kavionic/TeslaDriver/Schematics/TeslaDriverHP/BOM.ods

Id | Designator | Package | Quantity | Designation | Supplier and ref
3 | C1,C6,C7,C8,C9,C10,C11,C13,C15,C17,C19,C21,C23,C25,C29,C30,C31,C32,C34,C35,C36,C37 | C_0603 | 22 | 100n
2 | C2,C3,C4,C5,C12,C14,C16,C18,C20,C22,C24,C26 | C_0603 | 12 | 1u
5 | R1,R2 | R_0603 | 2 | 4k7
11 | R3,R4,R5,R6 | R_1206 | 4 | 2
1 | D5,D6,D7,D8,D13,D14,D15,D16 | Diode-SMA_Standard | 8 | SS210
9 | D1,D2,D3,D4,D9,D10,D11,D12 | MELF_Standard | 8 | ZMY12
12 | U3,U4,U5,U6 | SOIC-8_3.9x4.9mm_Pitch1.27mm | 4 | NCP81071A
13 | U1,U2 | TO-92_Inline_Narrow_Oval | 2 | DS18B20
7 | P1 | PinHeaderMale_2x08 | 1 | CONTROL
19 | C27,C28 | C_Radial_D16_L25_P7.5 | 2 | 1000u/63V
4 | C33,C38 | C_Rect_L18_W8_P15 | 2 | 2.2u/63V
6 | Q2,Q1,Q3,Q4 | TO-220 | 4 | STP65NF06
14 | P2 | PowerPad15_5 | 1 | PWR_IN+
15 | P3 | PowerPad15_5 | 1 | PWR_GND
16 | P4 | PowerPad15_5 | 1 | PWR_OUT_L1
17 | P5 | PowerPad15_5 | 1 | PWR_OUT_L2
18 | T4,T3,T2,T1 | GateTR10x4 | 4 | GateTR10x4
10 | M1,M2,M3,M4 | MH7x3 | 4 | MountingHole
