kavionic/TeslaDriver/Schematics/TeslaDriverHP/DualGateDriver.ods

Id | Designator | Package | Quantity | Designation | Supplier and ref
3 | C1,C7 | C_0603 | 2 | NP |  | 0
4 | C2,C3,C4 | C_0603 | 3 | 1u |  | 3
5 | C5,C6,C8,C10,C11,C12 | C_0603 | 6 | 100n |  | 6
6 | C9,C13 | C_1206 | 2 | 10u |  | 2
7 | D1,D3 | MELF_Standard | 2 | ZMY12 |  | 0
8 | D2,D5 | Diode-SMA_Standard | 2 | SS210 |  | 0
9 | D4,D6 | SMini2-F5-B | 2 | DZ2J130M0L |  | 2
10 | R1,R2,R9,R10 | R_1206 | 4 | 1 |  | 0
11 | R3,R4,R6,R8 | R_1206 | 4 | 3R9 (1) |  | 2
12 | R5,R7 | R_0603 | 2 | NP
13 | U2 | SOIC-8_3.9x4.9mm_Pitch1.27mm | 1 | L78L05ACD |  | 1
14 | U3 | SOIC-16_7.5x10.3mm_Pitch1.27mm | 1 | SI8233 |  | 1
15 | U5,U6 | NXE2_DCDC | 2 | NXE2S1212MC |  | 2
1 | U1,U4 | GateDriverSub | 2 | GateDriver
