kavionic/TeslaDriver/Schematics/TeslaDriverHP/GateDriver.ods

Id | Designator | Package | Quantity | Designation | Supplier and ref
1 | U1 | SOIC-8_3.9x4.9mm_Pitch1.27mm | 1 | NCP81071A
2 | C2,C3,C7,C8,C11 | C_0603 | 5 | 100n
3 | C4,C5,C9,C10 | C_0603 | 4 | 1u
5 | D1,D2 | Diode-SMA_Standard | 2 | SS210
6 | D3,D4 | MELF_Standard | 2 | ZMY12
7 | R1,R3 | R_1206 | 2 | 4R3
8 | R2,R4 | R_1206 | 2 | 1
9 | T1 | GateTR10x4_HV | 1 | GateTR10x4
10 | U2 | GateDriverSub | 1 | GateDriver
12 | C1,C6 | C_0603 | 2 | NP
11 | M1 | MH6 | 1 | MountingHole
