kavionic/TeslaDriver/Schematics/TeslaDriverHP2/TeslaDriver.ods

Id | Designator | Package | Quantity | Designation | Supplier and ref
2 | Q1,Q2,Q3,Q4 | TO-247 | 4 | IRFP4310ZPbF | Digi-Key: IRFP4310ZPBF-ND
7 | U5,U6 | TO-92_Inline_Narrow_Oval | 2 | DS18B20 | Ebay (Digi-Key: DS18B20+-ND)
9 | D1,D2,D3,D4 | DO-214AB | 4 | SK520 | Digi-Key: 1655-1603-1-ND
5 | C29,C30 | C_0603 | 2 | 100n | Digi-Key: 1276-1936-2-ND
8 | C5,C6,C7,C8,C9,C10,C11,C12,C13,C14,C15,C16,C17,C18,C19,C20,C21,C22,C23,C24,C25,C26,C27,C28 | C_0805 | 24 | 3n9/250V | Digi-Key: 445-15288-1-ND
3 | C1,C2 | C_Radial_D16_L25_P7.5 | 2 | 1000u/63V | Digi-Key: 399-6624-ND
12 | C3,C4 | C_Rect_L18_W8_P15 | 2 | 2.2u/63V | Ebay (Digi-Key: 495-4176-ND)
4 | R1,R14,R15 | R_0603 | 3 | 4k7 | Digi-Key: 311-4.70KHRTR-ND
10 | R2,R3,R4,R5,R6,R7,R8,R9,R10,R11,R12,R13 | R_2512 | 12 | 1 | Digi-Key: CRM2512-JW-1R0ELFCT-ND
11 | P3 | PinHeaderMale_2x08 | 1 | CONTROL
1 | U4,U1,U2,U3 | GateDriverMain | 4 | GateDriver
13 | P1 | PowerPad15_5_via | 1 | PWR_IN+
14 | P2 | PowerPad15_5_via | 1 | PWR_GND
15 | P4 | PowerPad15_5_via | 1 | PWR_OUT_L1
16 | P5 | PowerPad15_5_via | 1 | PWR_OUT_L2
6 | M1,M2,M3,M4 | MH7x3 | 4 | MountingHole
