kavionic/TeslaDriver/Schematics/TeslaController/TeslaController.ods

Id | Designator | Package | Quantity | Designation | Supplier and ref
7 | R10,R29 | R_0603 | 2 | 150
11 | R31 | R_0603 | 1 | 300
2 | R4 | R_0603 | 1 | 620
5 | R7,R9,R12,R32 | R_0603 | 4 | 1k
10 | R30 | R_0603 | 1 | 1k2
3 | R5 | R_0603 | 1 | 3k6
9 | R13,R14,R15,R16,R17,R18,R19,R20,R21,R22,R23,R24,R25,R26,R27,R28,R33,R34 | R_0603 | 18 | 4k7
4 | R6 | R_0603 | 1 | 6k8
1 | R1,R2,R3 | R_0603 | 3 | 10k
6 | R8 | R_0603 | 1 | 20k
8 | R11 | R_0603 | 1 | 68k
14 | C9,C13 | C_0603 | 2 | 10p
13 | C4,C10,C15,C21 | C_0603 | 4 | 1n
12 | C2,C3,C6,C7,C8,C11,C14,C17,C18,C19,C22,C20 | C_0603 | 12 | 100n
36 | L1 | L_1206 | 1 | 10u
15 | Y1 | Crystal-3225 | 1 | DSX321SH
16 | U4 | SOT-23 | 1 | TL431DBZ
17 | U3 | SOT-223 | 1 | AP1117D33
18 | U2 | SOT-223 | 1 | AP1117D50
19 | U1 | SOT-223 | 1 | AP1117
20 | Q9,Q8,Q7,Q6,Q5,Q4,Q3,Q2,Q1 | SOT-23 | 9 | BSS138
38 | D3,D2 | SOT-23 | 2 | BAT54S
39 | D1 | SOD-323 | 1 | BZX384-C3V6
40 | C16,C12 | c_elec_5x5.7 | 2 | 100u/10V
41 | C5,C1 | c_elec_6.3x7.7 | 2 | 100u/25V
27 | P10 | MicroSD | 1 | MicroSD
37 | IC1 | TQFP-64_14x14mm_Pitch0.8mm | 1 | ATXMEGA256A3-A
31 | P6 | PiezoBuzzer_17mm_SMD | 1 | BUZZER
42 | RV1 | Potentiometer_Tri5x5 | 1 | 10k
21 | P17 | PinHeaderMale_2x03 | 1 | CURRENT_SENS
22 | P16 | PinHeader_1x03 | 1 | TEMP2
23 | P15 | PinHeader_1x03 | 1 | TEMP1
24 | P14 | PinHeader_1x03 | 1 | INV_EN
25 | P13 | PinHeaderMale_2x06 | 1 | DISPLAY
26 | P11 | PinHeaderMale_2x04 | 1 | KEYBOARD
28 | P9 | PinHeader_1x04 | 1 | FAN2
29 | P8 | PinHeader_1x04 | 1 | FAN1
30 | P7 | PinHeaderMale_2x04 | 1 | EXPANSION
32 | P5 | PinHeader_1x04 | 1 | DEBUG
33 | P4 | PinHeaderMale_2x03 | 1 | ISP
35 | P2 | PinHeaderMale_2x03 | 1 | PWR_OUT1
44 | P1 | PinHeader_1x03 | 1 | PWR_IN
46 | P12 | PinHeaderMale_2x08 | 1 | INVERTER
34 | P3 | ESP-12E | 1 | ESP-12E
45 | REF**,REF**,REF**,REF** | MH6x3 | 4 | MH6x3
43 | REF**,REF**,REF** | Heatsink12x12 | 3 | Heatsink12x12
 |  |  | 93
