kavionic/TeslaDriver/Schematics/TeslaDriverHP2/QuadGateDriver_R1/QuadGateDriver.kicad_pcb

## KiCad design Schematics/TeslaDriverHP2/QuadGateDriver_R1/QuadGateDriver.kicad_pcb (2017-03-05)

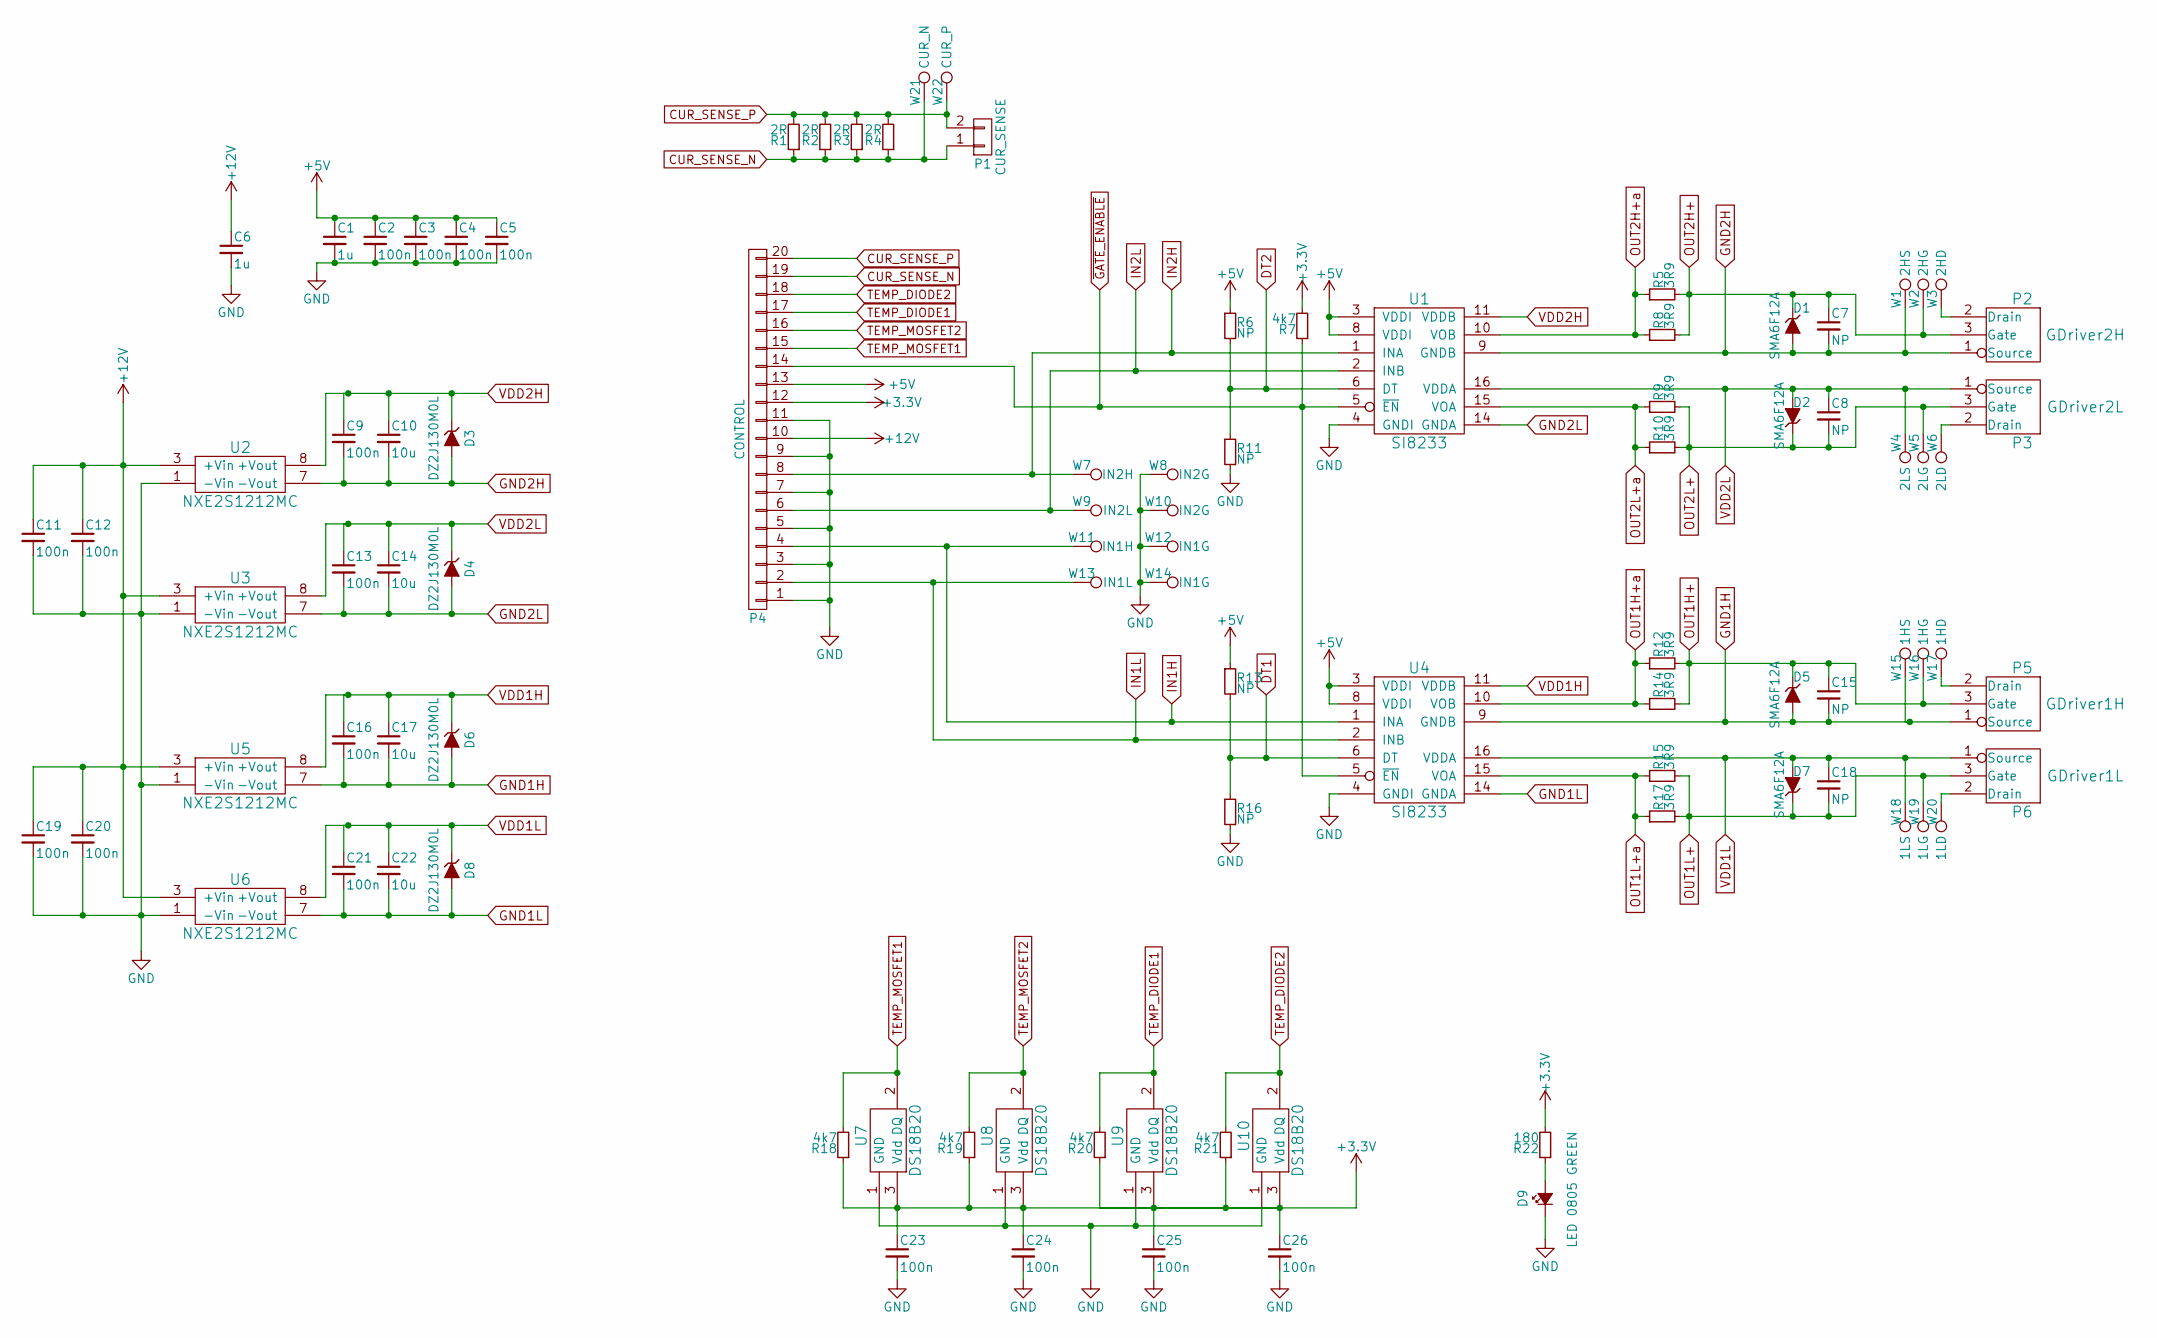
[picture p1: schematic QuadGateDriver.sch, VPower]

Parts:
C1, C6: 1u; C_0603
C2, C3, C4, C5, C9, C11, C12, C13, C16, C19, C20, C21, C23, C24, C25, C26: 100n; C_0603
C7, C8, C15, C18: NP; C_0603
C10, C14, C17, C22: 10u; C_1206
D1, D2, D5, D7: SMA6F12A; DO-221AC
D3, D4, D6, D8: DZ2J130M0L; SMini2-F5-B
D9: LED 0805 GREEN; LED_0805
P1: CUR_SENSE; PinHeader_1x02
P2: GDriver2H; SimpleGateDriverOut
P3: GDriver2L; SimpleGateDriverOut
P4: CONTROL; PinHeaderMale_2x10
P5: GDriver1H; SimpleGateDriverOut
P6: GDriver1L; SimpleGateDriverOut
R1, R2, R3, R4: 2R; R_1206
R5, R8, R9, R10, R12, R14, R15, R17: 3R9; R_1206
R6, R11, R13, R16: NP; R_0603
R7, R18, R19, R20, R21: 4k7; R_0603
R22: 180; R_0603
U1, U4: SI8233; SOIC-16_7.5x10.3mm_Pitch1.27mm
U2, U3, U5, U6: NXE2S1212MC; NXE2_DCDC
U7, U8, U9, U10: DS18B20; TO-92_Inline_Narrow_Oval
W1: 2HS; TestPoint06
W2: 2HG; TestPoint06
W3: 2HD; TestPoint06
W4: 2LS; TestPoint06
W5: 2LG; TestPoint06
W6: 2LD; TestPoint06
W7: IN2H; TestPoint06
W8, W10: IN2G; TestPoint06
W9: IN2L; TestPoint06
W11: IN1H; TestPoint06
W12, W14: IN1G; TestPoint06
W13: IN1L; TestPoint06
W15: 1HS; TestPoint06
W16: 1HG; TestPoint06
W17: 1HD; TestPoint06
W18: 1LS; TestPoint06
W19: 1LG; TestPoint06
W20: 1LD; TestPoint06
W21: CUR_N; TestPoint
W22: CUR_P; TestPoint

Connections:
+3V3: C23.1, C24.1, C25.1, C26.1, P4.12, R7.2, R18.1, R19.1, R20.1, R21.1, R22.2, U7.3 (Vdd), U8.3 (Vdd), U9.3 (Vdd), U10.3 (Vdd)
+5V: C1.1, C2.1, C3.1, C4.1, C5.1, P4.13, R6.1, R13.1, U1.3 (VDDI), U1.8 (VDDI), U4.3 (VDDI), U4.8 (VDDI)
+12V: C6.1, C11.1, C12.1, C19.1, C20.1, P4.10, U2.3 (+Vin), U3.3 (+Vin), U5.3 (+Vin), U6.3 (+Vin)
CUR_SENSE_N: P1.1, P4.19, R1.1, R2.1, R3.1, R4.1, W21.1
CUR_SENSE_P: P1.2, P4.20, R1.2, R2.2, R3.2, R4.2, W22.1
DT1: R13.2, R16.1, U4.6 (DT)
DT2: R6.2, R11.1, U1.6 (DT)
GND: C1.2, C2.2, C3.2, C4.2, C5.2, C6.2, C11.2, C12.2, C19.2, C20.2, C23.2, C24.2, C25.2, C26.2, D9.1 (K), P4.1, P4.3, P4.5, P4.7, P4.9, P4.11, R11.2, R16.2, U1.4 (GNDI), U2.1 (-Vin), U3.1 (-Vin), U4.4 (GNDI), U5.1 (-Vin), U6.1 (-Vin), U7.1 (GND), U8.1 (GND), U9.1 (GND), U10.1 (GND), W8.1, W10.1, W12.1, W14.1
GND1H: C15.2, C16.2, C17.2, D5.2 (A), D6.2 (A), P5.1 (Source), U4.9 (GNDB), U5.7 (-Vout), W15.1
GND1L: C21.2, C22.2, D8.2 (A), U4.14 (GNDA), U6.7 (-Vout)
GND2H: C7.2, C9.2, C10.2, D1.2 (A), D3.2 (A), P2.1 (Source), U1.9 (GNDB), U2.7 (-Vout), W1.1
GND2L: C13.2, C14.2, D4.2 (A), U1.14 (GNDA), U3.7 (-Vout)
IN1H: P4.4, U4.1 (INA), W11.1
IN1L: P4.2, U4.2 (INB), W13.1
IN2H: P4.8, U1.1 (INA), W7.1
IN2L: P4.6, U1.2 (INB), W9.1
unnamed: D9.2 (A), R22.1
unnamed: P2.2 (Drain), W3.1
unnamed: P3.2 (Drain), W6.1
unnamed: P5.2 (Drain), W17.1
unnamed: P6.2 (Drain), W20.1
OUT1H+: C15.1, D5.1 (K), P5.3 (Gate), R12.2, R14.2, W16.1
OUT1H+a: R12.1, R14.1, U4.10 (VOB)
OUT1L+: C18.2, D7.1 (K), P6.3 (Gate), R15.2, R17.2, W19.1
OUT1L+a: R15.1, R17.1, U4.15 (VOA)
OUT2H+: C7.1, D1.1 (K), P2.3 (Gate), R5.2, R8.2, W2.1
OUT2H+a: R5.1, R8.1, U1.10 (VOB)
OUT2L+: C8.2, D2.1 (K), P3.3 (Gate), R9.2, R10.2, W5.1
OUT2L+a: R9.1, R10.1, U1.15 (VOA)
TEMP_DIODE1: P4.17, R20.2, U9.2 (DQ)
TEMP_DIODE2: P4.18, R21.2, U10.2 (DQ)
TEMP_MOSFET1: P4.15, R18.2, U7.2 (DQ)
TEMP_MOSFET2: P4.16, R19.2, U8.2 (DQ)
VDD1H: C16.1, C17.1, D6.1 (K), U4.11 (VDDB), U5.8 (+Vout)
VDD1L: C18.1, C21.1, C22.1, D7.2 (A), D8.1 (K), P6.1 (Source), U4.16 (VDDA), U6.8 (+Vout), W18.1
VDD2H: C9.1, C10.1, D3.1 (K), U1.11 (VDDB), U2.8 (+Vout)
VDD2L: C8.1, C13.1, C14.1, D2.2 (A), D4.1 (K), P3.1 (Source), U1.16 (VDDA), U3.8 (+Vout), W4.1
~GATE_ENABLE: P4.14, R7.1, U1.5 (~EN), U4.5 (~EN)

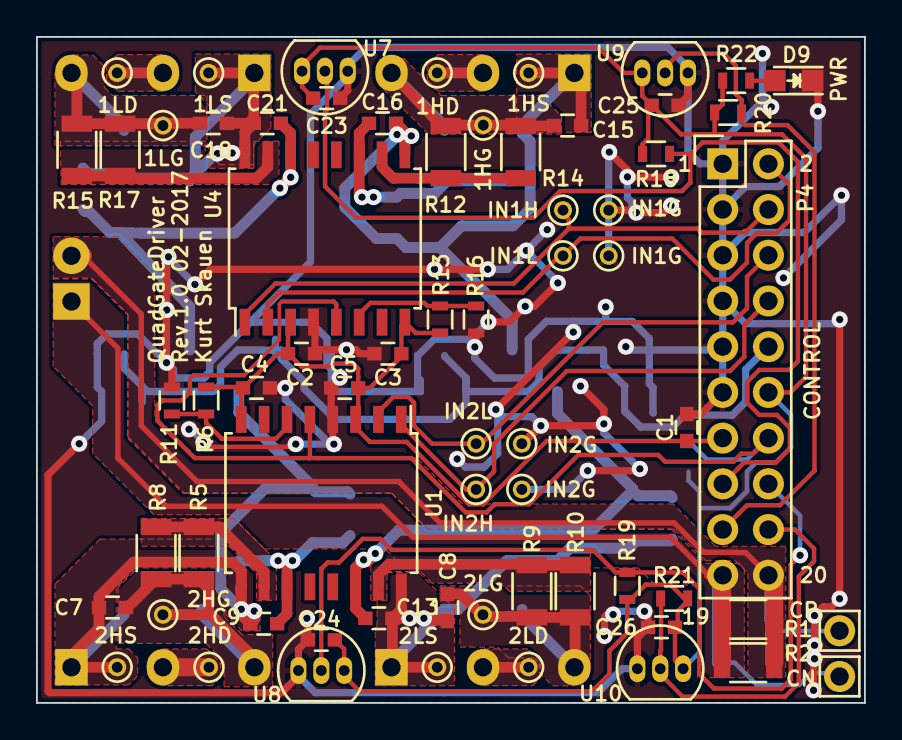
[picture p2: board QuadGateDriver.kicad_pcb from above]

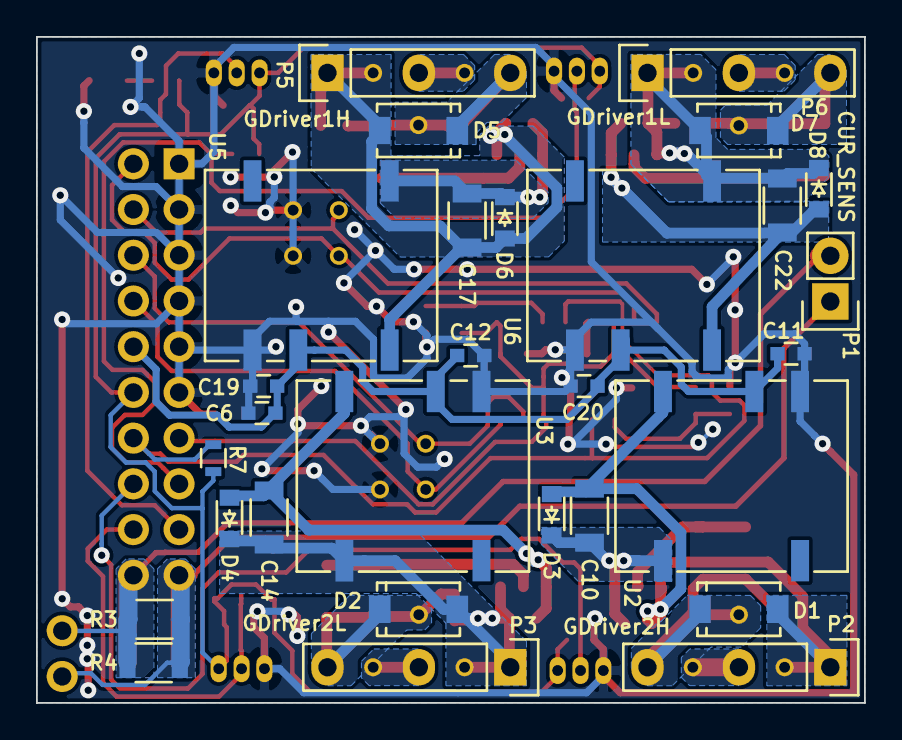
[picture p3: board QuadGateDriver.kicad_pcb from below]

Board: 2 copper layers, 46.0 x 37.0 mm, 95 parts (25 on the bottom side), 38 nets.
