kavionic/TeslaDriver/Schematics/TeslaDriverHP2/TeslaDriver.kicad_pcb

## KiCad design Schematics/TeslaDriverHP2/TeslaDriver.kicad_pcb (2017-03-05)

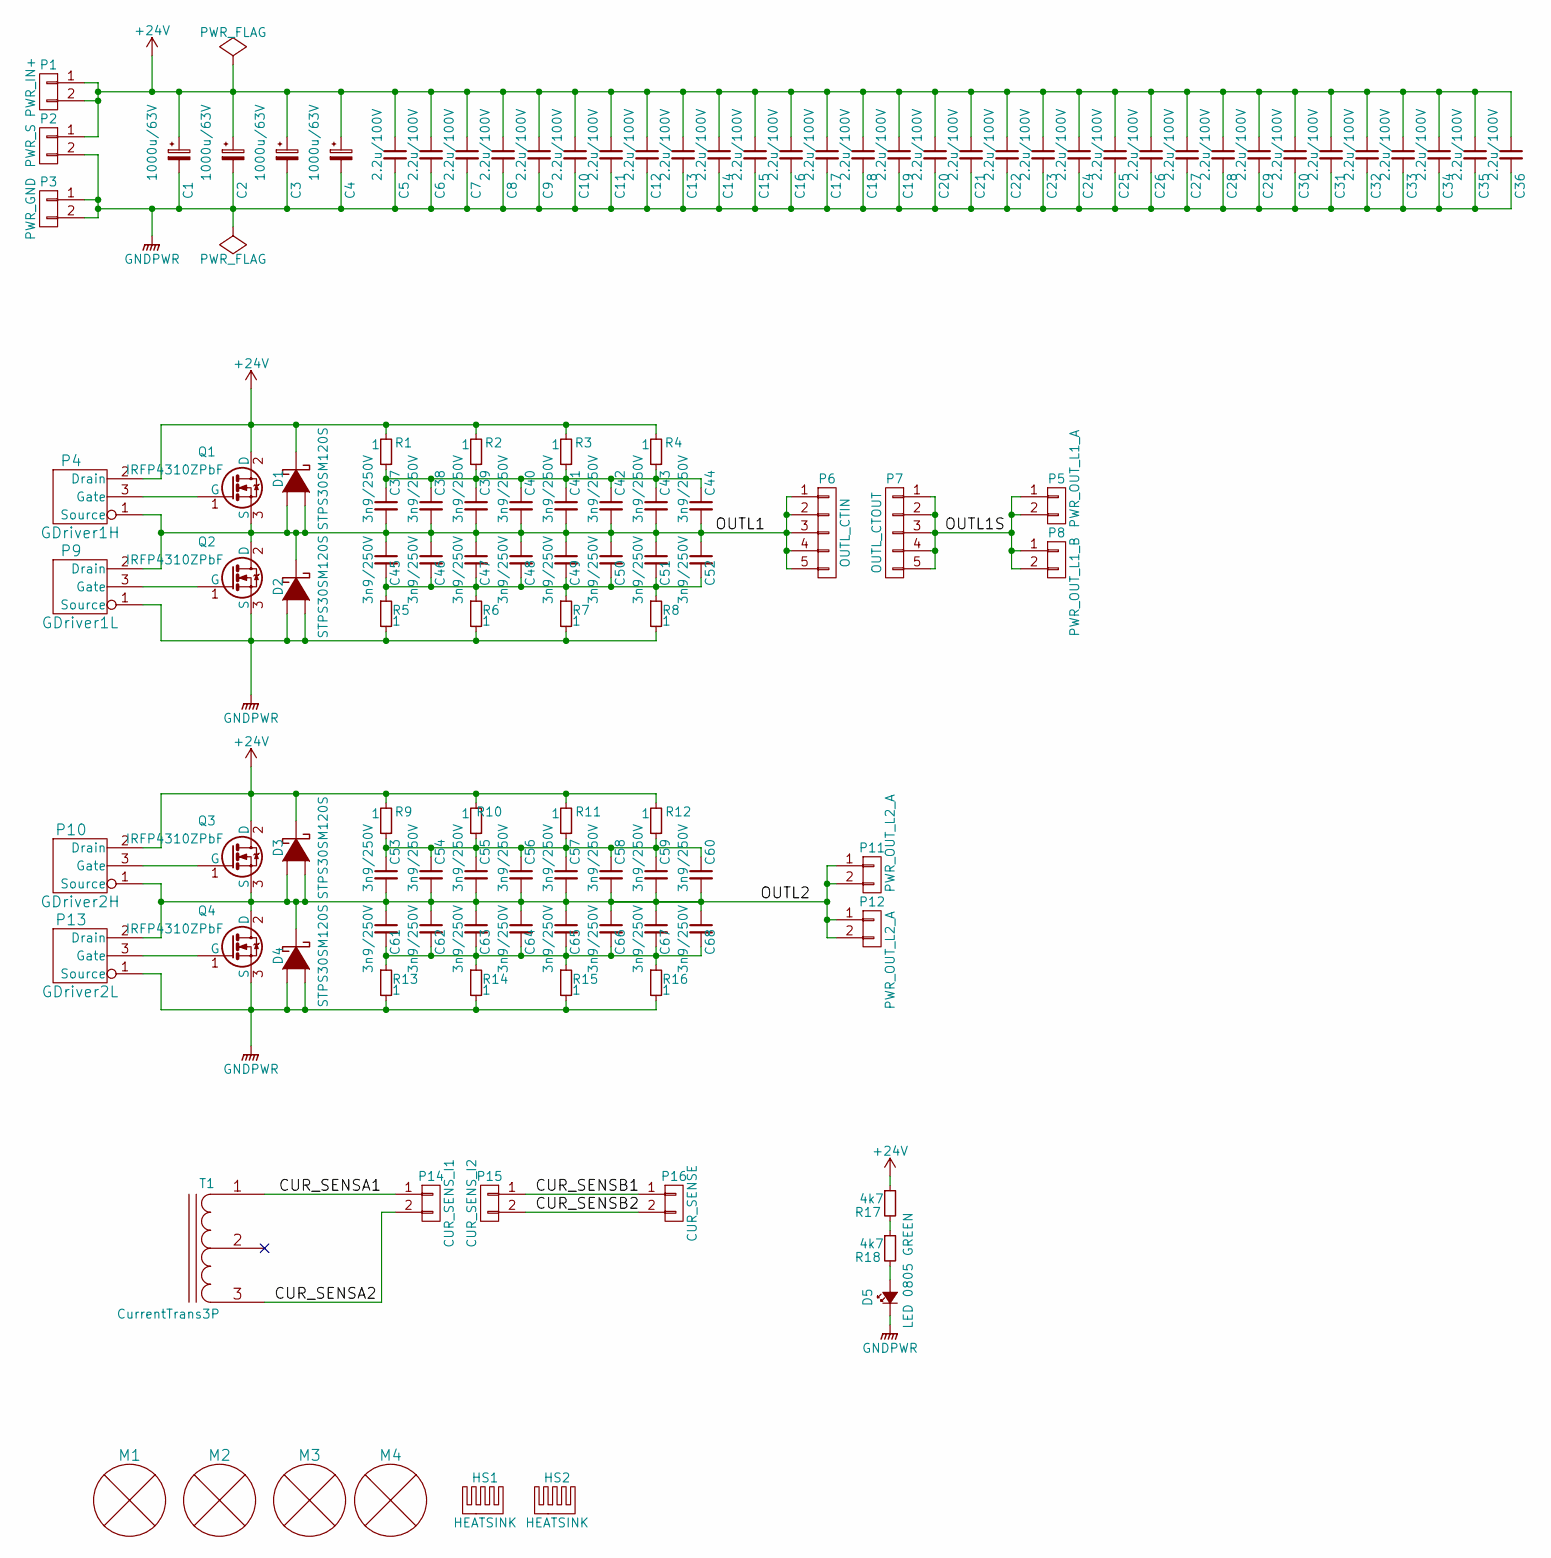
[picture p4: schematic TeslaDriver.sch, VPower]

Parts:
C1, C2, C3, C4: 1000u/63V; C_Radial_D16_L25_P7.5
C5, C6, C7, C8, C9, C10, C11, C12, C13, C14, C15, C16, C17, C18, C19, C20, C21, C22, C23, C24, C25, C26, C27, C28, C29, C30, C31, C32, C33, C34, C35, C36: 2.2u/100V; C_1210
C37, C38, C39, C40, C41, C42, C43, C44, C45, C46, C47, C48, C49, C50, C51, C52, C53, C54, C55, C56, C57, C58, C59, C60, C61, C62, C63, C64, C65, C66, C67, C68: 3n9/250V; C_0805
D1, D2, D3, D4: STPS30SM120S; TO-220
D5: LED 0805 GREEN; LED_0805
HS1, HS2: HEATSINK; Heatsink12Fin73x60x25
M1, M2, M3, M4: MountingHole; MH7x3
P1: PWR_IN+; TermBlock6.35mm2P
P2: PWR_S; TermBlock6.35mm2P
P3: PWR_GND; TermBlock6.35mm2P
P4: GDriver1H; SimpleGateDriver
P5: PWR_OUT_L1_A; TermBlock6.35mm2P
P6: OUTL_CTIN; CurrentSensConnector
P7: OUTL_CTOUT; CurrentSensConnector
P8: PWR_OUT_L1_B; TermBlock6.35mm2P
P9: GDriver1L; SimpleGateDriver
P10: GDriver2H; SimpleGateDriver
P11, P12: PWR_OUT_L2_A; TermBlock6.35mm2P
P13: GDriver2L; SimpleGateDriver
P14: CUR_SENS_I1; PinHeader_1x02
P15: CUR_SENS_I2; PinHeader_1x02
P16: CUR_SENSE; PinHeader_1x02
Q1, Q2, Q3, Q4: IRFP4310ZPbF; TO-247
R1, R2, R3, R4, R5, R6, R7, R8, R9, R10, R11, R12, R13, R14, R15, R16: 1; R_2512
R17, R18: 4k7; R_1206
T1: CurrentTrans3P; CurrentTrans3P27x10

Connections:
+24V: C1.1, C2.1, C3.1, C4.1, C5.1, C6.1, C7.1, C8.1, C9.1, C10.1, C11.1, C12.1, C13.1, C14.1, C15.1, C16.1, C17.1, C18.1, C19.1, C20.1, C21.1, C22.1, C23.1, C24.1, C25.1, C26.1, C27.1, C28.1, C29.1, C30.1, C31.1, C32.1, C33.1, C34.1, C35.1, C36.1, D1.2 (K), D3.2 (K), P1.1, P1.2, P2.1, P4.2 (Drain), P10.2 (Drain), Q1.2 (D), Q3.2 (D), R1.2, R2.2, R3.2, R4.2, R9.2, R10.2, R11.2, R12.2, R17.1
/CUR_SENSA1: P14.1, T1.1
/CUR_SENSA2: P14.2, T1.3
/CUR_SENSB1: P15.1, P16.1
/CUR_SENSB2: P15.2, P16.2
/OUTL1: C37.2, C38.2, C39.2, C40.2, C41.2, C42.2, C43.2, C44.2, C45.1, C46.1, C47.1, C48.1, C49.1, C50.1, C51.1, C52.1, D1.1 (A1), D1.3 (A2), D2.2 (K), P4.1 (Source), P6.1, P6.2, P6.3, P6.4, P6.5, P9.2 (Drain), Q1.3 (S), Q2.2 (D)
/OUTL1S: P5.1, P5.2, P7.1, P7.2, P7.3, P7.4, P7.5, P8.1, P8.2
/OUTL2: C53.2, C54.2, C55.2, C56.2, C57.2, C58.2, C59.2, C60.2, C61.1, C62.1, C63.1, C64.1, C65.1, C66.1, C67.1, C68.1, D3.1 (A1), D3.3 (A2), D4.2 (K), P10.1 (Source), P11.1, P11.2, P12.1, P12.2, P13.2 (Drain), Q3.3 (S), Q4.2 (D)
GNDPWR: C1.2, C2.2, C3.2, C4.2, C5.2, C6.2, C7.2, C8.2, C9.2, C10.2, C11.2, C12.2, C13.2, C14.2, C15.2, C16.2, C17.2, C18.2, C19.2, C20.2, C21.2, C22.2, C23.2, C24.2, C25.2, C26.2, C27.2, C28.2, C29.2, C30.2, C31.2, C32.2, C33.2, C34.2, C35.2, C36.2, D2.1 (A1), D2.3 (A2), D4.1 (A1), D4.3 (A2), D5.1 (K), P2.2, P3.1, P3.2, P9.1 (Source), P13.1 (Source), Q2.3 (S), Q4.3 (S), R5.2, R6.2, R7.2, R8.2, R13.2, R14.2, R15.2, R16.2
unnamed: C37.1, C38.1, C39.1, C40.1, C41.1, C42.1, C43.1, C44.1, R1.1, R2.1, R3.1, R4.1
unnamed: C45.2, C46.2, C47.2, C48.2, C49.2, C50.2, C51.2, C52.2, R5.1, R6.1, R7.1, R8.1
unnamed: C53.1, C54.1, C55.1, C56.1, C57.1, C58.1, C59.1, C60.1, R9.1, R10.1, R11.1, R12.1
unnamed: C61.2, C62.2, C63.2, C64.2, C65.2, C66.2, C67.2, C68.2, R13.1, R14.1, R15.1, R16.1
unnamed: D5.2 (A), R18.2
unnamed: P4.3 (Gate), Q1.1 (G)
unnamed: P9.3 (Gate), Q2.1 (G)
unnamed: P10.3 (Gate), Q3.1 (G)
unnamed: P13.3 (Gate), Q4.1 (G)
unnamed: R17.2, R18.1

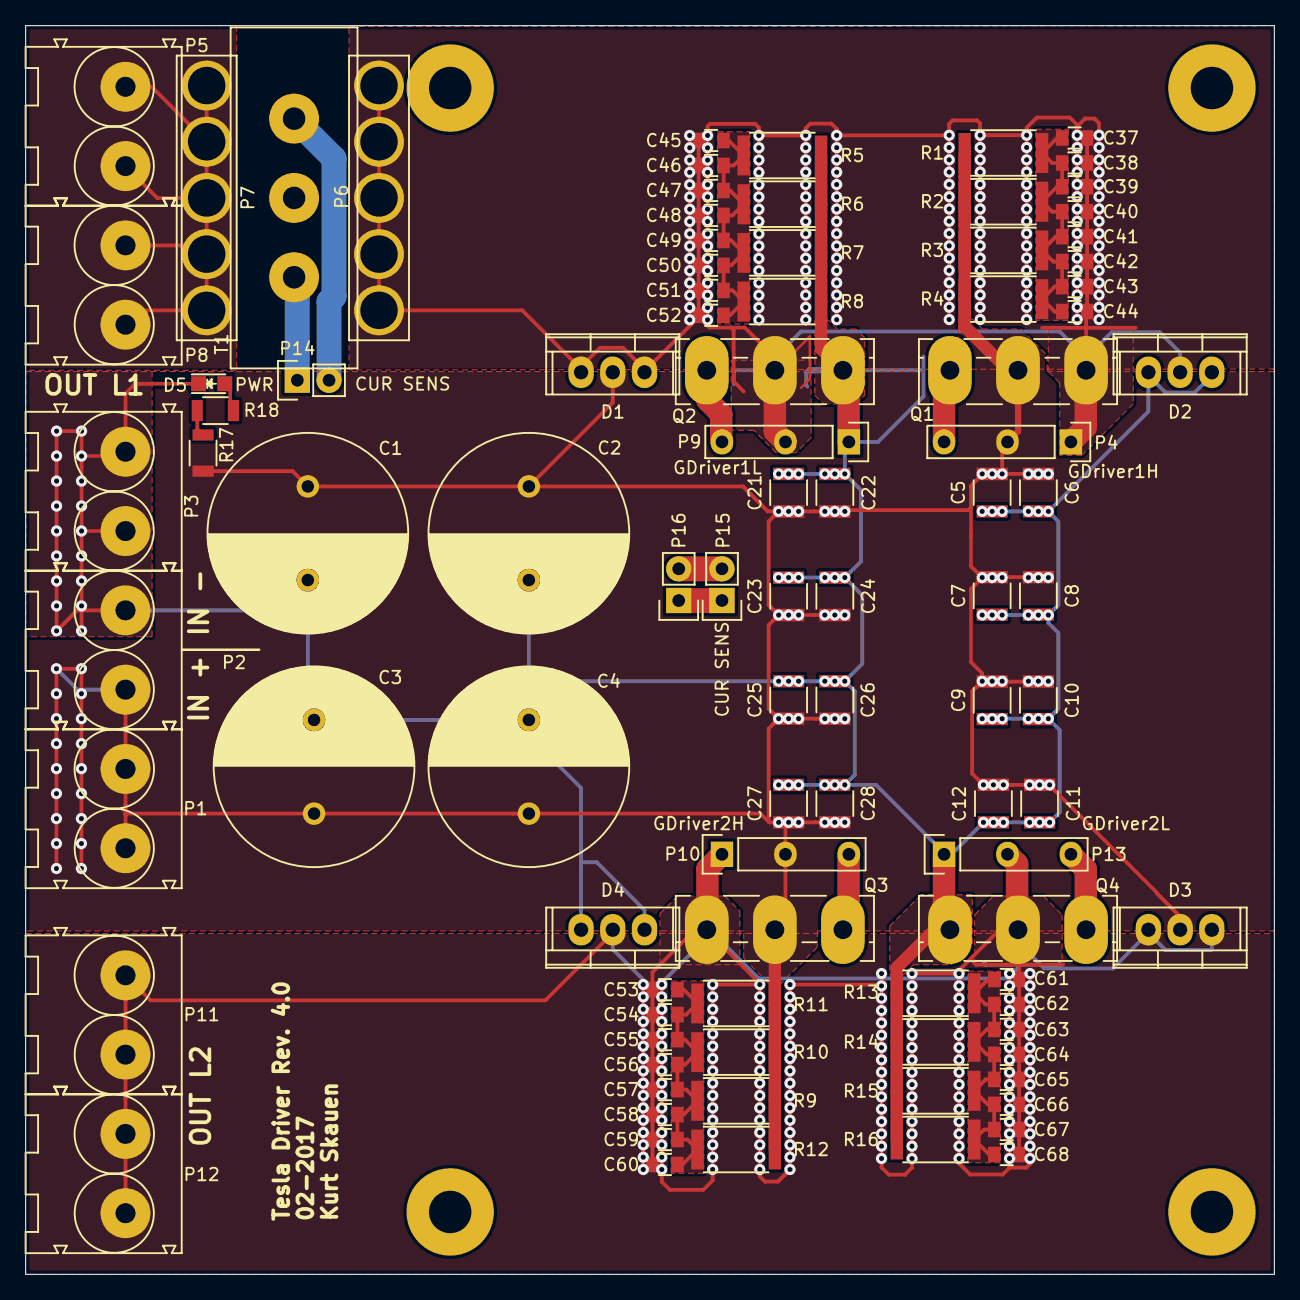
[picture p5: board Schematics/TeslaDriverHP2/TeslaDriver.kicad_pcb from above]

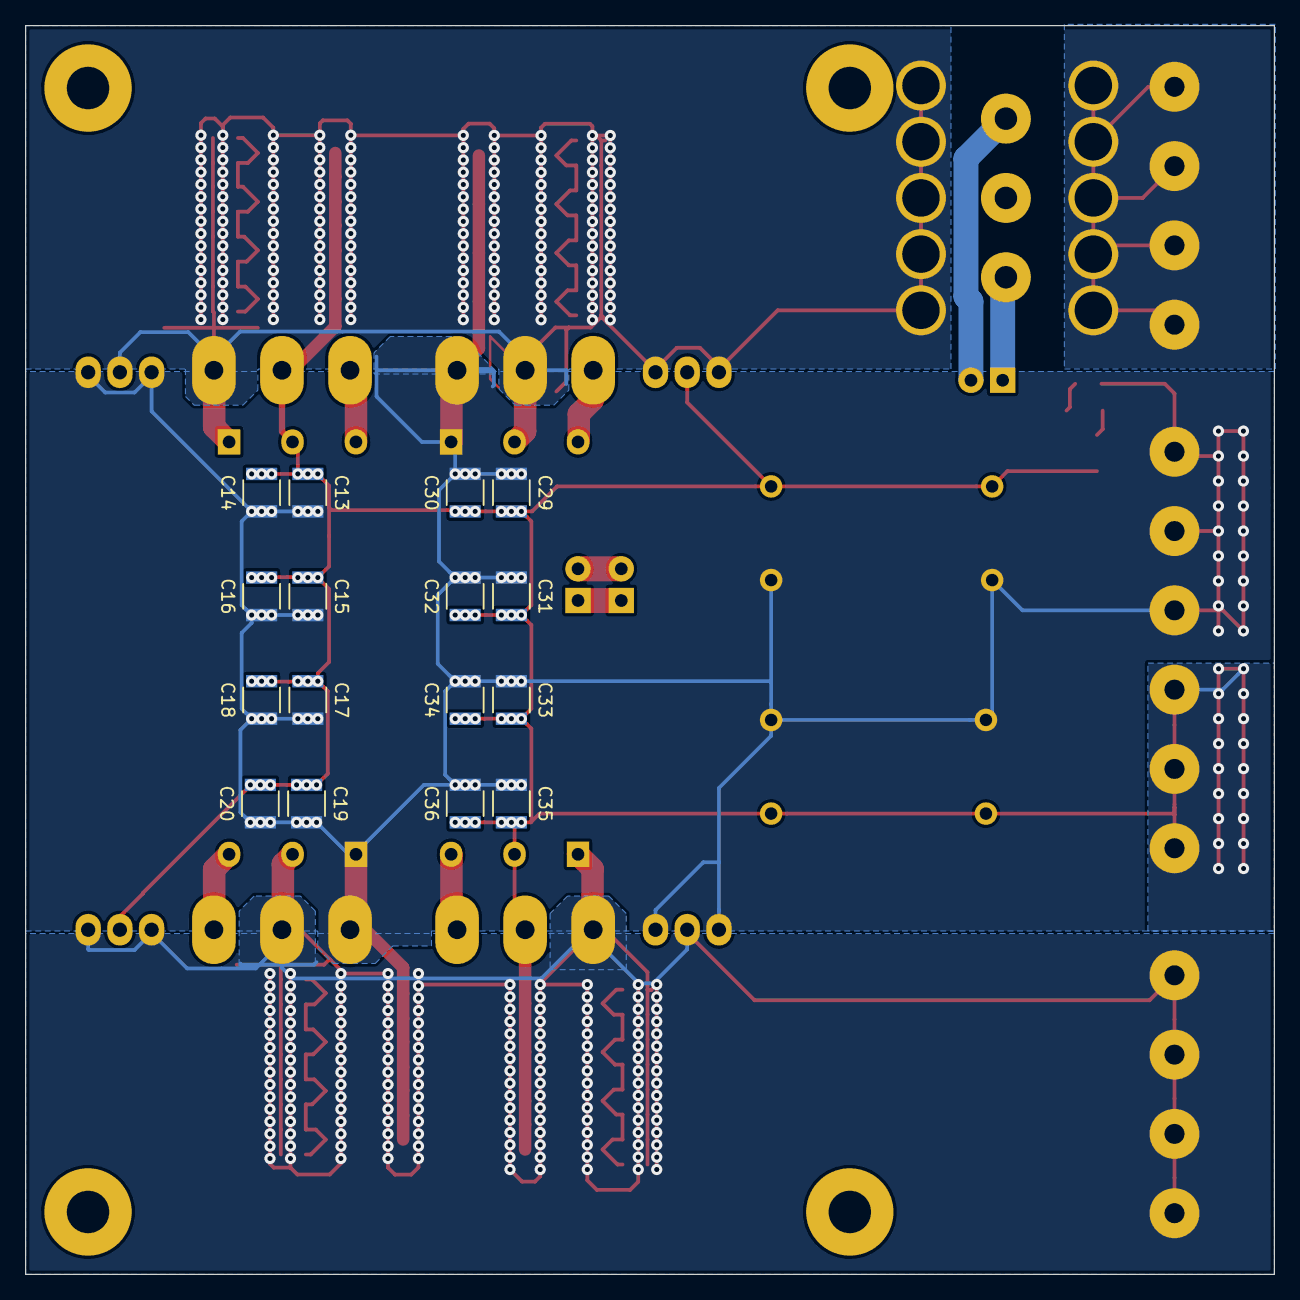
[picture p6: board Schematics/TeslaDriverHP2/TeslaDriver.kicad_pcb from below]

Board: 2 copper layers, 100.0 x 100.0 mm, 118 parts (16 on the bottom side), 19 nets.
