kavionic/TeslaDriver/Schematics/TeslaDriverHP/DualGateDriver.kicad_pcb

## KiCad design Schematics/TeslaDriverHP/DualGateDriver.kicad_pcb (2016-12-16)

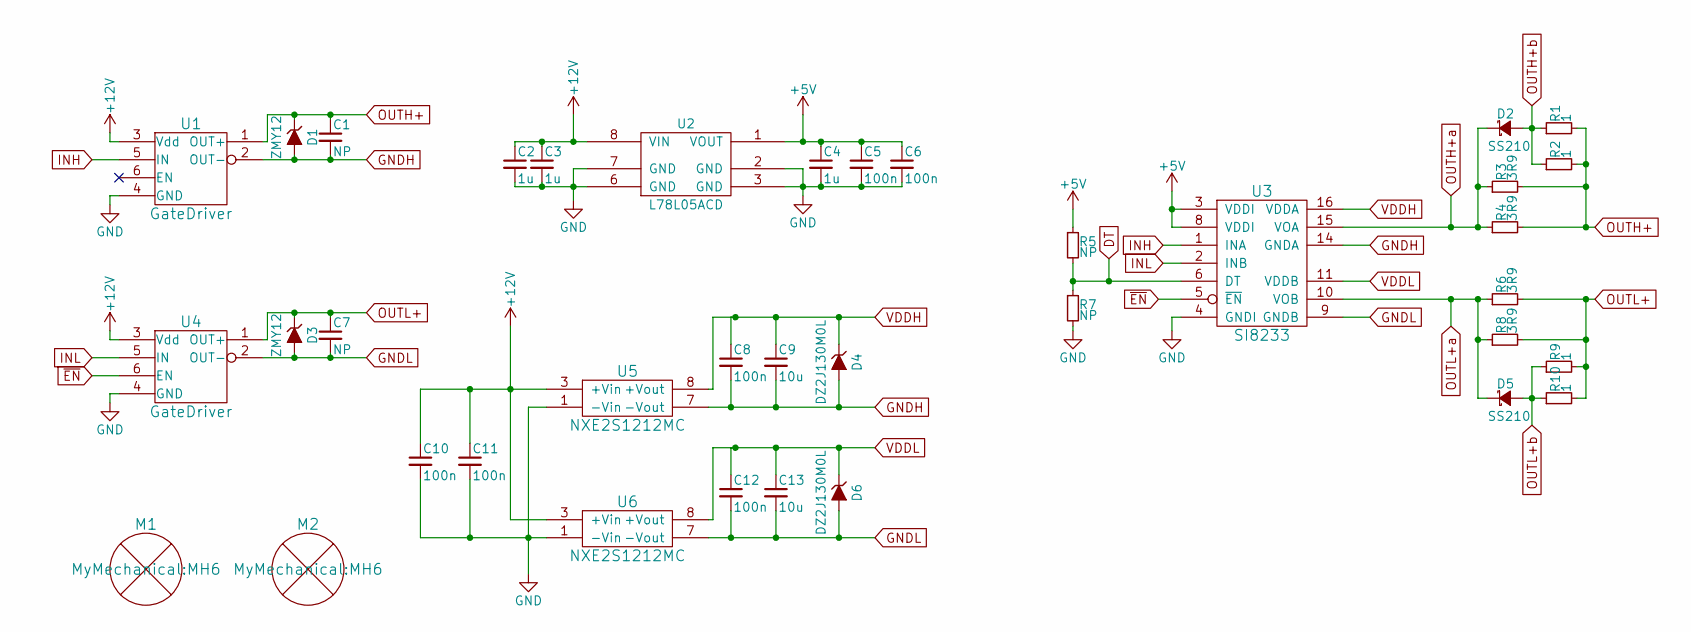
[picture p9: schematic DualGateDriver.sch, VPower]

Parts:
C1, C7: NP; C_0603
C2, C3, C4: 1u; C_0603
C5, C6, C8, C10, C11, C12: 100n; C_0603
C9, C13: 10u; C_1206
D1, D3: ZMY12; MELF_Standard
D2, D5: SS210; Diode-SMA_Standard
D4, D6: DZ2J130M0L; SMini2-F5-B
M1, M2: MountingHole; MH6
R1, R2, R9, R10: 1; R_1206
R3, R4, R6, R8: 3R9; R_1206
R5, R7: NP; R_0603
U1, U4: GateDriver; GateDriverSub
U2: L78L05ACD; SOIC-8_3.9x4.9mm_Pitch1.27mm
U3: SI8233; SOIC-16_7.5x10.3mm_Pitch1.27mm
U5, U6: NXE2S1212MC; NXE2_DCDC

Connections:
+5V: C4.1, C5.1, C6.1, R5.1, U2.1 (VOUT), U3.3 (VDDI), U3.8 (VDDI)
+12V: C2.1, C3.1, C10.1, C11.1, U1.3 (Vdd), U2.8 (VIN), U4.3 (Vdd), U5.3 (+Vin), U6.3 (+Vin)
DT: R5.2, R7.1, U3.6 (DT)
GND: C2.2, C3.2, C4.2, C5.2, C6.2, C10.2, C11.2, R7.2, U1.4 (GND), U2.2 (GND), U2.3 (GND), U2.6 (GND), U2.7 (GND), U3.4 (GNDI), U4.4 (GND), U5.1 (-Vin), U6.1 (-Vin)
GNDH: C1.2, C8.2, C9.2, D1.2 (A), D4.2 (A), U1.2 (OUT-), U3.14 (GNDA), U5.7 (-Vout)
GNDL: C7.2, C12.2, C13.2, D3.2 (A), D6.2 (A), U3.9 (GNDB), U4.2 (OUT-), U6.7 (-Vout)
INH: U1.5 (IN), U3.1 (INA)
INL: U3.2 (INB), U4.5 (IN)
OUTH+: C1.1, D1.1 (K), R1.2, R2.2, R3.2, R4.2, U1.1 (OUT+)
OUTH+a: D2.1 (K), R3.1, R4.1, U3.15 (VOA)
OUTH+b: D2.2 (A), R1.1, R2.1
OUTL+: C7.1, D3.1 (K), R6.2, R8.2, R9.2, R10.2, U4.1 (OUT+)
OUTL+a: D5.1 (K), R6.1, R8.1, U3.10 (VOB)
OUTL+b: D5.2 (A), R9.1, R10.1
VDDH: C8.1, C9.1, D4.1 (K), U3.16 (VDDA), U5.8 (+Vout)
VDDL: C12.1, C13.1, D6.1 (K), U3.11 (VDDB), U6.8 (+Vout)
~EN: U3.5 (~EN), U4.6 (EN)

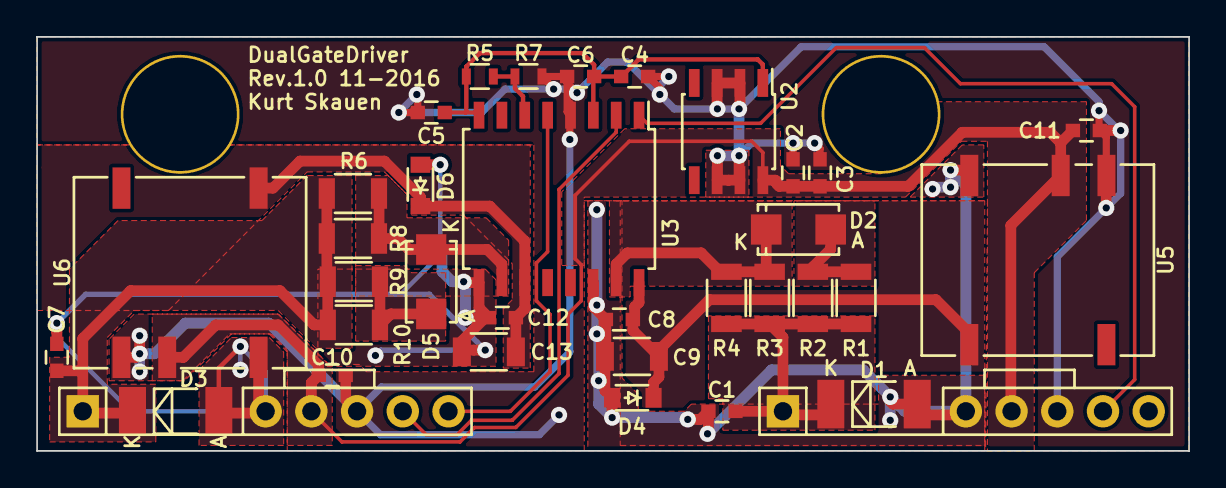
[picture p10: board DualGateDriver.kicad_pcb from above]

Board: 2 copper layers, 64.0 x 23.0 mm, 37 parts (0 on the bottom side), 17 nets.
