kavionic/TeslaDriver/Schematics/TeslaDriverHP/GateDriver.kicad_pcb

## KiCad design Schematics/TeslaDriverHP/GateDriver.kicad_pcb (2016-12-16)

Schematic: GateDriver.sch, VPower

Parts:
C1, C6: NP; C_0603
C2, C3, C7, C8, C11: 100n; C_0603
C4, C5, C9, C10: 1u; C_0603
D1, D2: SS210; Diode-SMA_Standard
D3, D4: ZMY12; MELF_Standard
M1: MountingHole; MH6
R1, R3: 4; R_1206
R2, R4: 1; R_1206
T1: GateTR10x4; GateTR10x4_HV
U1: NCP81071A; SOIC-8_3.9x4.9mm_Pitch1.27mm
U2: GateDriver; GateDriverSub

Connections:
+12V: C9.1, C10.1, C11.1, U1.6, U2.3 (Vdd)
EN: U1.8, U2.6 (EN)
GND: C9.2, C10.2, C11.2, U1.2, U1.3, U2.4 (GND)
IN: U1.1, U1.4, U2.5 (IN)
unnamed: C1.2, C3.2, C5.1, R1.1, R3.1
unnamed: C2.1, C4.1, R2.2, R4.2
unnamed: C2.2, C4.2, T1.3
unnamed: C3.1, C5.2, T1.1
unnamed: C7.1, D1.1 (K), D3.1 (K)
unnamed: C8.1, D2.2 (A), D4.2 (A)
unnamed: R2.1, R4.1, U1.7
unnamed: T1.4, U1.5
OUT+: C1.1, C6.1, D1.2 (A), D2.1 (K), R1.2, R3.2, U2.1 (OUT+)
OUT-: C6.2, C7.2, C8.2, D3.2 (A), D4.1 (K), T1.2, U2.2 (OUT-)

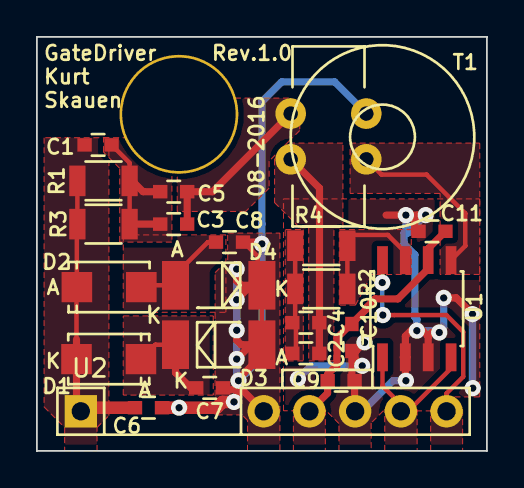
[picture p11: board GateDriver.kicad_pcb from above]

Board: 2 copper layers, 25.0 x 23.0 mm, 23 parts (0 on the bottom side), 14 nets.
