kavionic/TeslaDriver/Schematics/TeslaDriverHP/TeslaDriverHP.kicad_pcb

## KiCad design Schematics/TeslaDriverHP/TeslaDriverHP.kicad_pcb (2016-12-16)

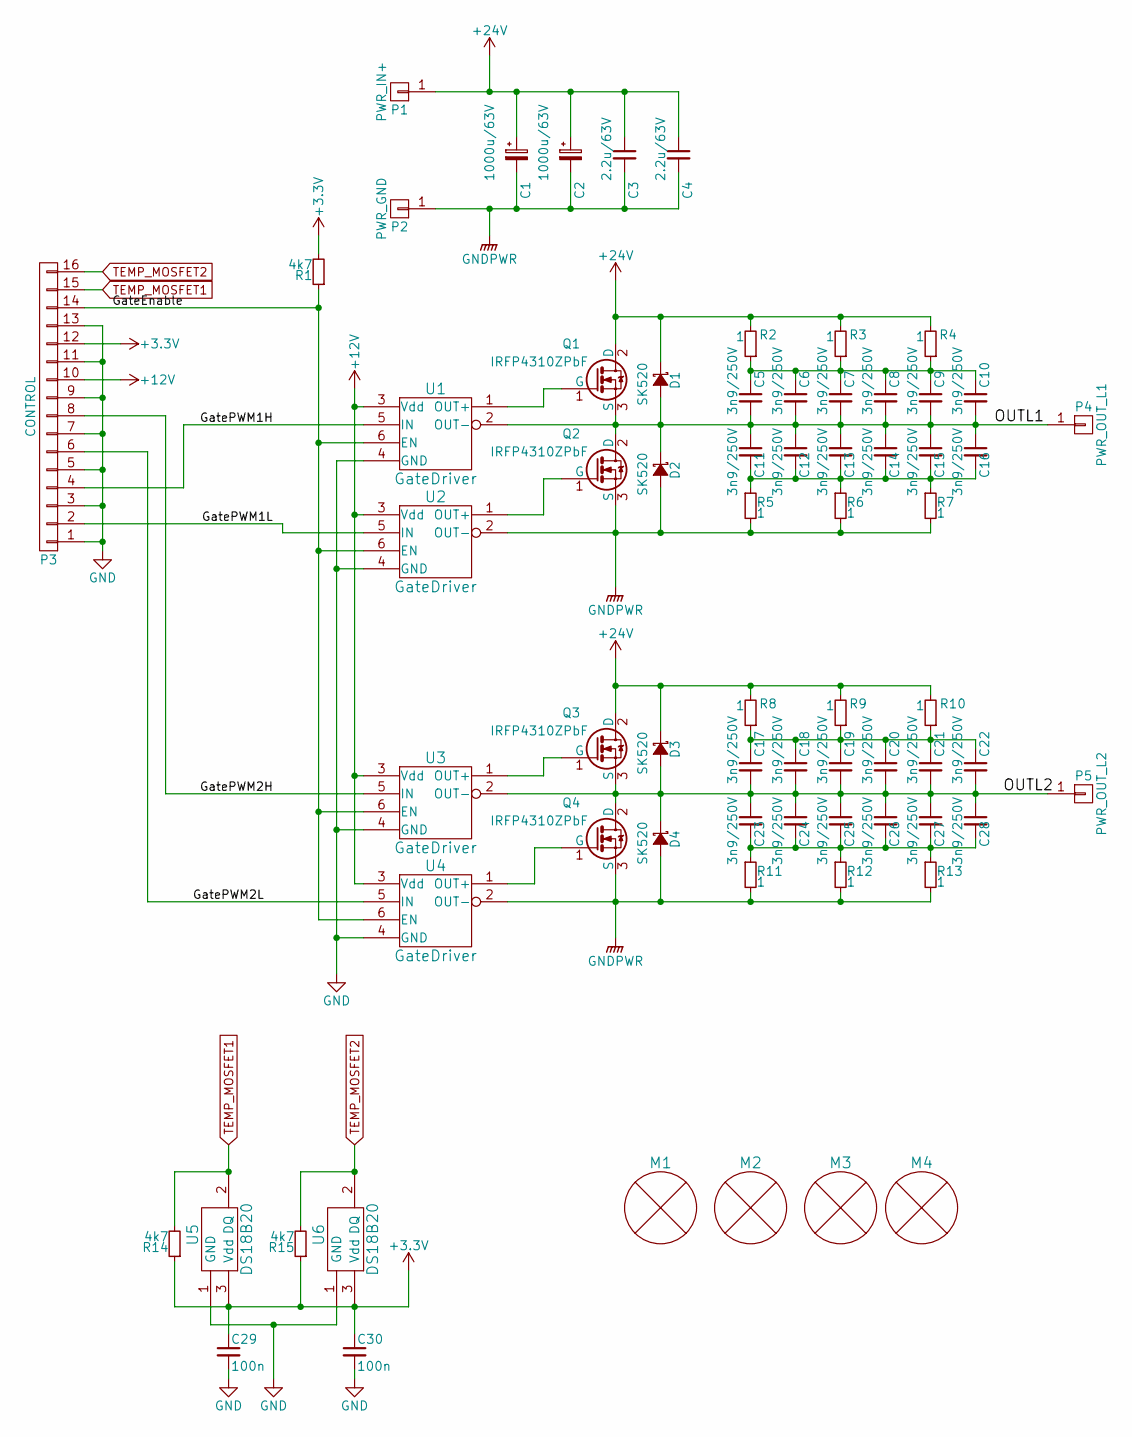
[picture p12: schematic TeslaDriverHP.sch, VPower]

Parts:
C1, C2: 1000u/63V; C_Radial_D16_L25_P7.5
C3, C4: 2.2u/63V; C_Rect_L18_W8_P15
C5, C6, C7, C8, C9, C10, C11, C12, C13, C14, C15, C16, C17, C18, C19, C20, C21, C22, C23, C24, C25, C26, C27, C28: 3n9/250V; C_0805
C29, C30: 100n; C_0603
D1, D2, D3, D4: SK520; DO-214AB
M1, M2, M3, M4: MountingHole; MH7x3
P1: PWR_IN+; PowerPad15_5_via
P2: PWR_GND; PowerPad15_5_via
P3: CONTROL; PinHeaderMale_2x08
P4: PWR_OUT_L1; PowerPad15_5_via
P5: PWR_OUT_L2; PowerPad15_5_via
Q1, Q2, Q3, Q4: IRFP4310ZPbF; TO-247
R1, R14, R15: 4k7; R_0603
R2, R3, R4, R5, R6, R7, R8, R9, R10, R11, R12, R13: 1; R_2512
U1, U2, U3, U4: GateDriver; GateDriverMain
U5, U6: DS18B20; TO-92_Inline_Narrow_Oval

Connections:
+3V3: C29.1, C30.1, P3.12, R1.2, R14.1, R15.1, U5.3 (Vdd), U6.3 (Vdd)
+12V: P3.10, U1.3 (Vdd), U2.3 (Vdd), U3.3 (Vdd), U4.3 (Vdd)
+24V: C1.1, C2.1, C3.1, C4.1, D1.1 (K), D3.1 (K), P1.1, Q1.2 (D), Q3.2 (D), R2.2, R3.2, R4.2, R8.2, R9.2, R10.2
/GateEnable: P3.14, R1.1, U1.6 (EN), U2.6 (EN), U3.6 (EN), U4.6 (EN)
/GatePWM1H: P3.4, U1.5 (IN)
/GatePWM1L: P3.2, U2.5 (IN)
/GatePWM2H: P3.8, U3.5 (IN)
/GatePWM2L: P3.6, U4.5 (IN)
/OUTL1: C5.2, C6.2, C7.2, C8.2, C9.2, C10.2, C11.1, C12.1, C13.1, C14.1, C15.1, C16.1, D1.2 (A), D2.1 (K), P4.1, Q1.3 (S), Q2.2 (D), U1.2 (OUT-)
/OUTL2: C17.2, C18.2, C19.2, C20.2, C21.2, C22.2, C23.1, C24.1, C25.1, C26.1, C27.1, C28.1, D3.2 (A), D4.1 (K), P5.1, Q3.3 (S), Q4.2 (D), U3.2 (OUT-)
GND: C29.2, C30.2, P3.1, P3.3, P3.5, P3.7, P3.9, P3.11, P3.13, U1.4 (GND), U2.4 (GND), U3.4 (GND), U4.4 (GND), U5.1 (GND), U6.1 (GND)
GNDPWR: C1.2, C2.2, C3.2, C4.2, D2.2 (A), D4.2 (A), P2.1, Q2.3 (S), Q4.3 (S), R5.2, R6.2, R7.2, R11.2, R12.2, R13.2, U2.2 (OUT-), U4.2 (OUT-)
unnamed: C5.1, C6.1, C7.1, C8.1, C9.1, C10.1, R2.1, R3.1, R4.1
unnamed: C11.2, C12.2, C13.2, C14.2, C15.2, C16.2, R5.1, R6.1, R7.1
unnamed: C17.1, C18.1, C19.1, C20.1, C21.1, C22.1, R8.1, R9.1, R10.1
unnamed: C23.2, C24.2, C25.2, C26.2, C27.2, C28.2, R11.1, R12.1, R13.1
unnamed: Q1.1 (G), U1.1 (OUT+)
unnamed: Q2.1 (G), U2.1 (OUT+)
unnamed: Q3.1 (G), U3.1 (OUT+)
unnamed: Q4.1 (G), U4.1 (OUT+)
TEMP_MOSFET1: P3.15, R14.2, U5.2 (DQ)
TEMP_MOSFET2: P3.16, R15.2, U6.2 (DQ)

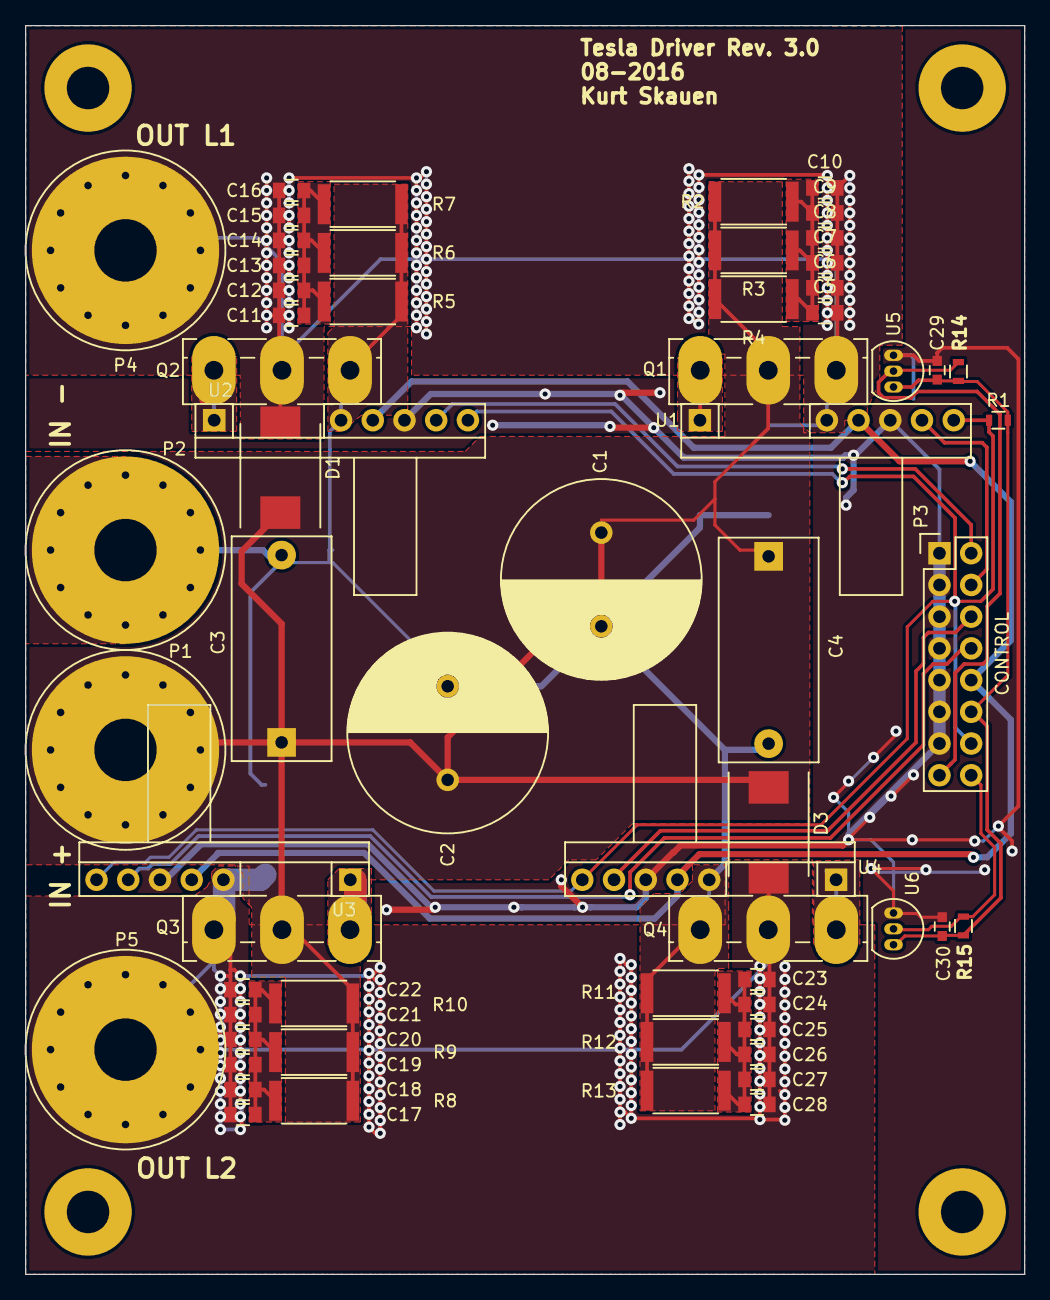
[picture p13: board TeslaDriverHP.kicad_pcb from above]

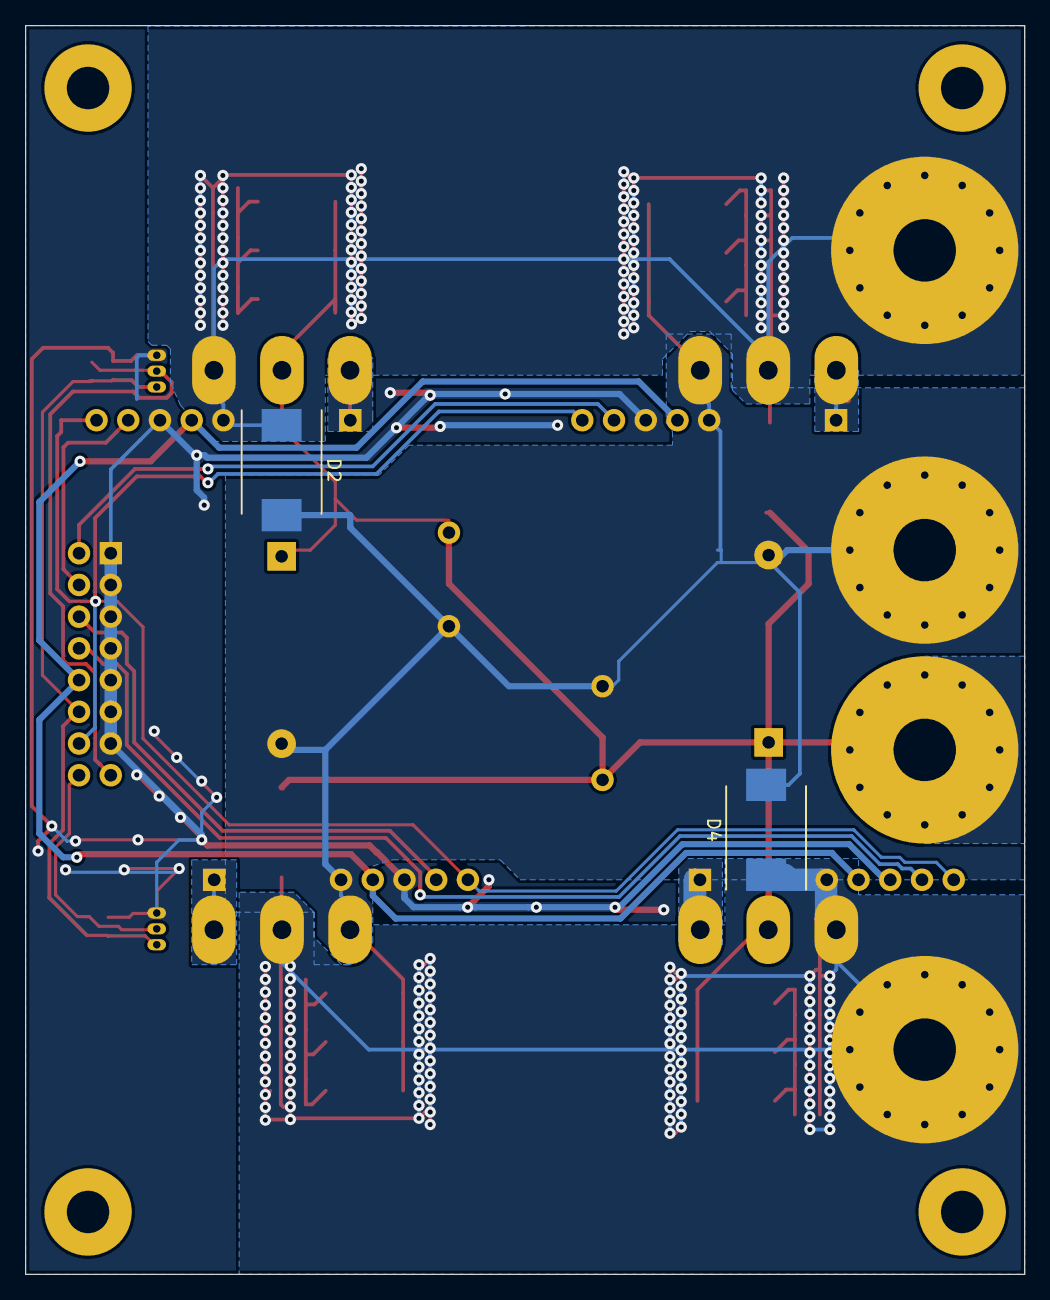
[picture p14: board TeslaDriverHP.kicad_pcb from below]

Board: 2 copper layers, 80.0 x 100.0 mm, 68 parts (2 on the bottom side), 22 nets.
