kavionic/TeslaDriver/Schematics/TeslaDriver/TeslaDriver.kicad_pcb

## KiCad design Schematics/TeslaDriver/TeslaDriver.kicad_pcb (2016-08-19, an earlier design)

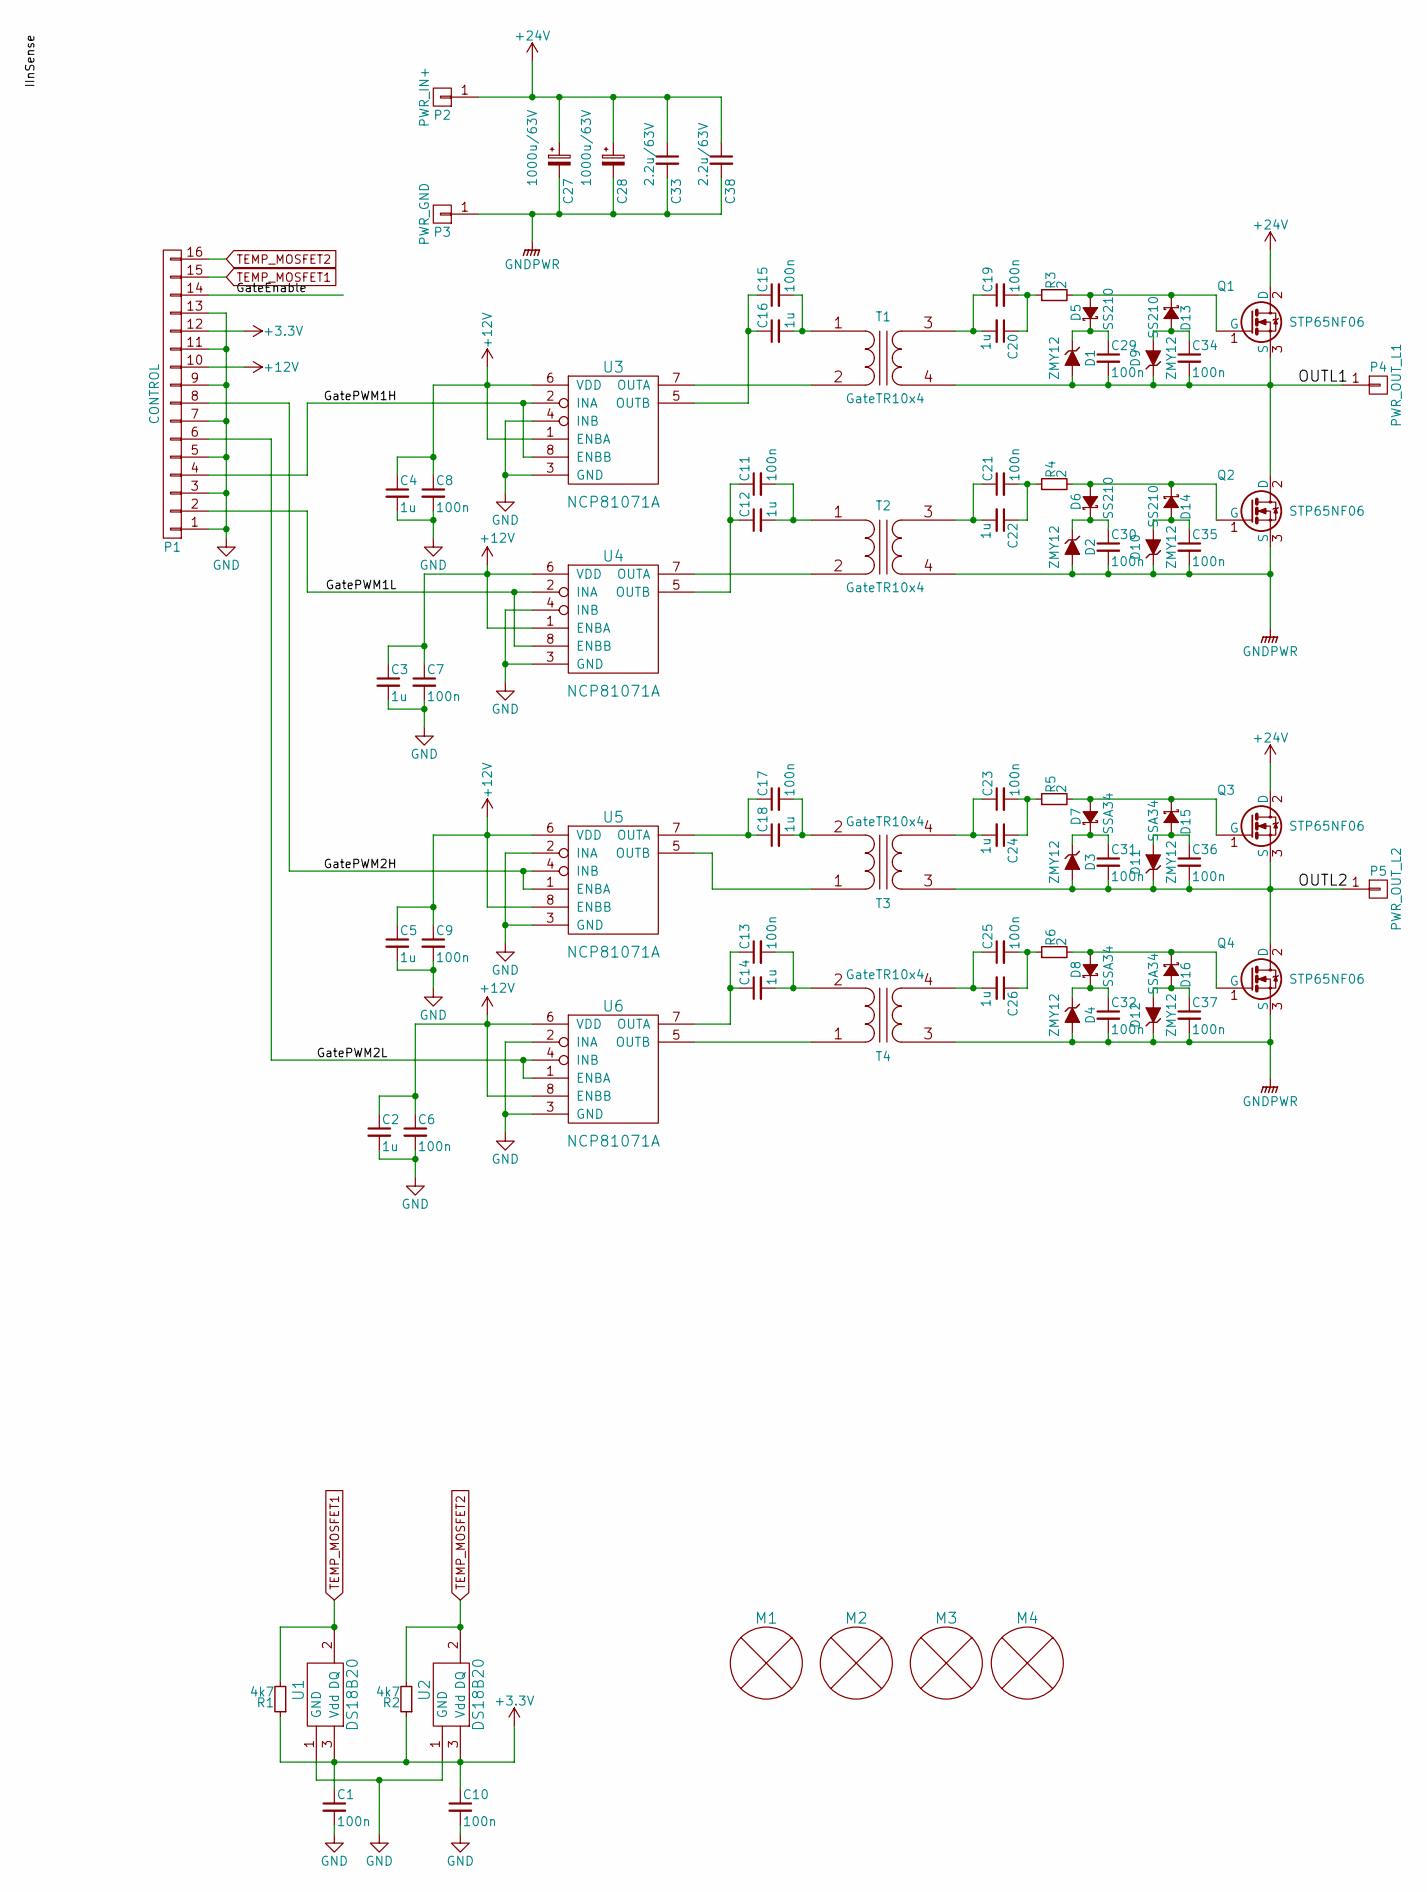
[picture p15: schematic TeslaDriver.sch, VPower]

Parts:
C1, C6, C7, C8, C9, C10, C11, C13, C15, C17, C19, C21, C23, C25, C29, C30, C31, C32, C34, C35, C36, C37: 100n; C_0603
C2, C3, C4, C5, C12, C14, C16, C18, C20, C22, C24, C26: 1u; C_0603
C27, C28: 1000u/63V; C_Radial_D16_L25_P7.5
C33, C38: 2.2u/63V; C_Rect_L18_W8_P15
D1, D2, D3, D4, D9, D10, D11, D12: ZMY12; MELF_Standard
D5, D6, D13, D14: SS210; Diode-SMA_Standard
D7, D8, D15, D16: SSA34; Diode-SMA_Standard
M1, M2, M3, M4: MountingHole; MH7x3
P1: CONTROL; PinHeaderMale_2x08
P2: PWR_IN+; PowerPad15_5
P3: PWR_GND; PowerPad15_5
P4: PWR_OUT_L1; PowerPad15_5
P5: PWR_OUT_L2; PowerPad15_5
Q1, Q2, Q3, Q4: STP65NF06; TO-220
R1, R2: 4k7; R_0603
R3, R4, R5, R6: 2; R_1206
T1, T2, T3, T4: GateTR10x4
U1, U2: DS18B20; TO-92_Inline_Narrow_Oval
U3, U4, U5, U6: NCP81071A; SOIC-8_3.9x4.9mm_Pitch1.27mm

Connections:
+3V3: C1.1, C10.1, P1.12, R1.1, R2.1, U1.3 (Vdd), U2.3 (Vdd)
+12V: C2.1, C3.1, C4.1, C5.1, C6.1, C7.1, C8.1, C9.1, P1.10, U3.1 (ENBA), U3.6 (VDD), U4.1 (ENBA), U4.6 (VDD), U5.6 (VDD), U5.8 (ENBB), U6.6 (VDD), U6.8 (ENBB)
+24V: C27.1, C28.1, C33.1, C38.1, P2.1, Q1.2 (D), Q3.2 (D)
/GatePWM1H: P1.4, U3.2 (INA), U3.8 (ENBB)
/GatePWM1L: P1.2, U4.2 (INA), U4.8 (ENBB)
/GatePWM2H: P1.8, U5.1 (ENBA), U5.4 (INB)
/GatePWM2L: P1.6, U6.1 (ENBA), U6.4 (INB)
/OUTL1: C29.2, C34.2, D1.2 (A), D9.1 (K), P4.1, Q1.3 (S), Q2.2 (D), T1.4 (S2)
/OUTL2: C31.2, C36.2, D3.2 (A), D11.1 (K), P5.1, Q3.3 (S), Q4.2 (D), T3.3 (S1)
GND: C1.2, C2.2, C3.2, C4.2, C5.2, C6.2, C7.2, C8.2, C9.2, C10.2, P1.1, P1.3, P1.5, P1.7, P1.9, P1.11, P1.13, U1.1 (GND), U2.1 (GND), U3.3 (GND), U3.4 (INB), U4.3 (GND), U4.4 (INB), U5.2 (INA), U5.3 (GND), U6.2 (INA), U6.3 (GND)
GNDPWR: C27.2, C28.2, C30.2, C32.2, C33.2, C35.2, C37.2, C38.2, D2.2 (A), D4.2 (A), D10.1 (K), D12.1 (K), P3.1, Q2.3 (S), Q4.3 (S), T2.4 (S2), T4.3 (S1)
unnamed: C11.1, C12.1, U4.5 (OUTB)
unnamed: C11.2, C12.2, T2.1
unnamed: C13.1, C14.1, U6.7 (OUTA)
unnamed: C13.2, C14.2, T4.2
unnamed: C15.1, C16.1, U3.5 (OUTB)
unnamed: C15.2, C16.2, T1.1
unnamed: C17.1, C18.1, U5.7 (OUTA)
unnamed: C17.2, C18.2, T3.2
unnamed: C19.1, C20.2, T1.3 (S1)
unnamed: C19.2, C20.1, R3.1
unnamed: C21.1, C22.2, T2.3 (S1)
unnamed: C21.2, C22.1, R4.1
unnamed: C23.1, C24.2, T3.4 (S2)
unnamed: C23.2, C24.1, R5.1
unnamed: C25.1, C26.2, T4.4 (S2)
unnamed: C25.2, C26.1, R6.1
unnamed: C29.1, D1.1 (K), D5.1 (K)
unnamed: C30.1, D2.1 (K), D6.1 (K)
unnamed: C31.1, D3.1 (K), D7.1 (K)
unnamed: C32.1, D4.1 (K), D8.1 (K)
unnamed: C34.1, D9.2 (A), D13.2 (A)
unnamed: C35.1, D10.2 (A), D14.2 (A)
unnamed: C36.1, D11.2 (A), D15.2 (A)
unnamed: C37.1, D12.2 (A), D16.2 (A)
unnamed: D5.2 (A), D13.1 (K), Q1.1 (G), R3.2
unnamed: D6.2 (A), D14.1 (K), Q2.1 (G), R4.2
unnamed: D7.2 (A), D15.1 (K), Q3.1 (G), R5.2
unnamed: D8.2 (A), D16.1 (K), Q4.1 (G), R6.2
unnamed: T1.2, U3.7 (OUTA)
unnamed: T2.2, U4.7 (OUTA)
unnamed: T3.1, U5.5 (OUTB)
unnamed: T4.1, U6.5 (OUTB)
TEMP_MOSFET1: P1.15, R1.2, U1.2 (DQ)
TEMP_MOSFET2: P1.16, R2.2, U2.2 (DQ)

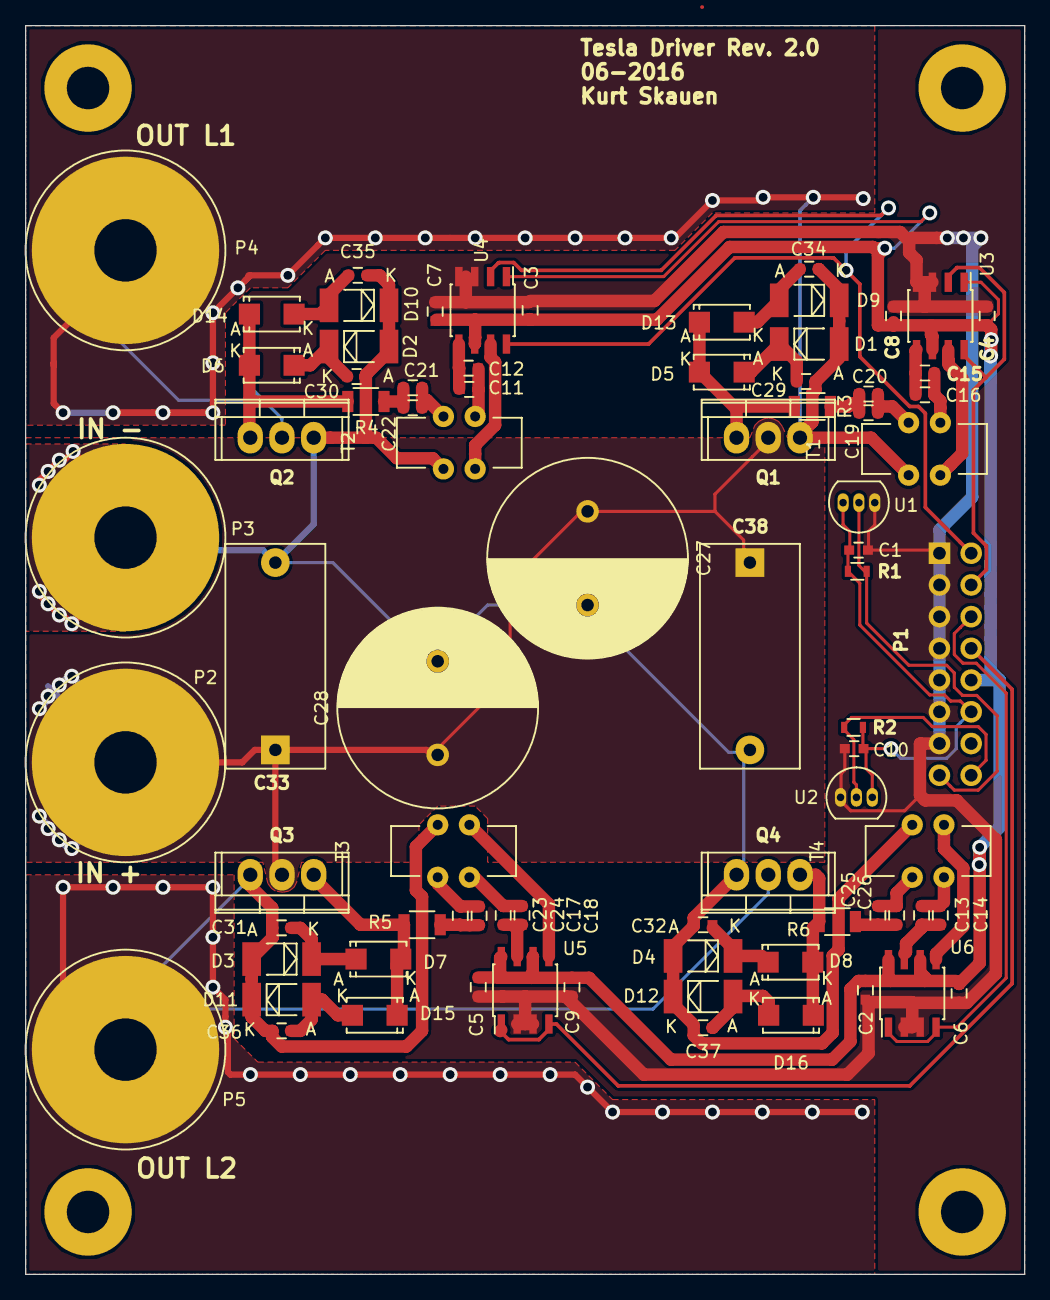
[picture p16: board Schematics/TeslaDriver/TeslaDriver.kicad_pcb from above]

Board: 2 copper layers, 80.0 x 100.0 mm, 83 parts (0 on the bottom side), 45 nets.
