kavionic/TeslaDriver/Firmware/TeslaDriver/TeslaDriver/PWMController.cpp

// This file is part of TeslaDriver.
//
// Copyright (C) 2016 Kurt Skauen <http://kavionic.com/>
//
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
#include <avr/io.h>
#include <avr/interrupt.h>
#include <avr/sleep.h>
#include <avr/pgmspace.h>
#include <stdio.h>

#include "PWMController.h"
#include "Hardware.h"
#include "SystemStats.h"

#include "Misc/DigitalPort.h"
#include "Misc/Utils.h"
#include "Misc/Clock.h"

static const int16_t PWM_MODULATION_BUFFER_SIZE = 8192;

static uint8_t g_ModulationBuffer[PWM_MODULATION_BUFFER_SIZE];
static volatile int16_t g_ModulationBufferBytesAvailable;
static volatile int16_t g_ModulationBufferInPos;
static volatile int16_t g_ModulationBufferOutPos;
//static volatile int16_t g_LastModulationBufferSample;

struct PWMModulationPair
{
    uint16_t m_Low;
    uint16_t m_High;
};

static PWMModulationPair g_ModulationDMABuffer[2][PWMController::MODULATION_DMA_BUFFER_SIZE];
static volatile bool g_ValidDMABuffers[2];

static uint8_t  g_ModulationMultiplier = 157;
static uint8_t  g_ModulationShifter = 7;
static uint16_t g_DutyCycle;
static uint16_t g_PWMThreshold;
//static uint16_t g_PWMMinThreshold;
//static int16_t g_PWMMaxSampleDelta;
static int16_t g_PWMModulationCenter;

#define DMA_CHANNEL_CTRL (DMA_CH_REPEAT_bm | DMA_CH_SINGLE_bm | DMA_CH_BURSTLEN_4BYTE_gc)
///////////////////////////////////////////////////////////////////////////////
///
///////////////////////////////////////////////////////////////////////////////

static inline void ScaleModulationData(PWMModulationPair* dst, const uint8_t* data, int16_t size)
{
    int16_t maxVal = PWM_TIMER.PERBUF>>1;
    for (int16_t i = 0 ; i < size ; ++i)
    {
        int16_t sample = (uint16_t(data[i] * g_ModulationMultiplier) >> g_ModulationShifter) + g_PWMModulationCenter;
        if (sample < 0 /*I16(g_PWMMinThreshold)*/) {
            sample = 0; //g_PWMMinThreshold;
        } else if ( sample > maxVal ) {
             sample = maxVal;
        }
        dst[i].m_Low = sample;
        dst[i].m_High = PWM_TIMER.PERBUF - sample;
    }
}

///////////////////////////////////////////////////////////////////////////////
///
///////////////////////////////////////////////////////////////////////////////

static inline void FillDMABuffers(uint8_t channel)
{
    int16_t bytesWritten = 0;
    while(g_ModulationBufferBytesAvailable && bytesWritten < PWMController::MODULATION_DMA_BUFFER_SIZE)
    {
        int16_t sizeToEnd = min(PWM_MODULATION_BUFFER_SIZE - g_ModulationBufferOutPos, g_ModulationBufferBytesAvailable);
        if ( sizeToEnd > PWMController::MODULATION_DMA_BUFFER_SIZE - bytesWritten) sizeToEnd = PWMController::MODULATION_DMA_BUFFER_SIZE - bytesWritten;
        sei();
        ScaleModulationData(g_ModulationDMABuffer[channel] + bytesWritten, g_ModulationBuffer + g_ModulationBufferOutPos, sizeToEnd);
        cli();
        g_ModulationBufferOutPos += sizeToEnd;
        g_ModulationBufferOutPos &= PWM_MODULATION_BUFFER_SIZE - 1;
        g_ModulationBufferBytesAvailable -= sizeToEnd;
        bytesWritten += sizeToEnd;
    }    

    uint16_t transferCount;
    if (bytesWritten != 0)
    {
        g_ValidDMABuffers[channel] = true;
        transferCount = bytesWritten<<2;
    }
    else
    {
        g_ModulationDMABuffer[channel][0].m_Low = g_PWMThreshold;
        g_ModulationDMABuffer[channel][0].m_High = PWM_TIMER.PERBUF - g_PWMThreshold;
        g_ValidDMABuffers[channel] = false;
        transferCount = 4;
    }
    if (channel == 0) {
        DMA.CH0.TRFCNT = transferCount;
    } else {
        DMA.CH1.TRFCNT = transferCount;
    }
}

///////////////////////////////////////////////////////////////////////////////
///
///////////////////////////////////////////////////////////////////////////////

static inline void HandleDMAInterrupt(uint8_t channel)
{
    FillDMABuffers(channel);
    if (!g_ValidDMABuffers[0] && !g_ValidDMABuffers[1]) // Both DMA buffers empty. Stop the DMA timer and reset the PWM duty cycle.
    {
        PWM_MODULATION_TIMER.CTRLA = TC_CLKSEL_OFF_gc;
        PWM_TIMER.PWM_CMP_LO_PWM = g_PWMThreshold;
        PWM_TIMER.PWM_CMP_HI_PWM = PWM_TIMER.PER - g_PWMThreshold;

        g_SystemStats.m_DSPCyclesMax  = 0;
        g_SystemStats.m_DSPCyclesMin  = 0;
        g_SystemStats.m_DSPCyclesPrev = 0;

        printf_P(PSTR("S%d\n"), channel);
    }
}

///////////////////////////////////////////////////////////////////////////////
///
///////////////////////////////////////////////////////////////////////////////

ISR(DMA_CH0_vect)
{
    if ( DMA.INTFLAGS & DMA_CH0TRNIF_bm )
    {
        uint16_t cycles = SYSTEM_TIMER.CNT;
        DMA.INTFLAGS = DMA_CH0TRNIF_bm;
        HandleDMAInterrupt(0);
        cycles = SYSTEM_TIMER.CNT - cycles;
        if (cycles > g_SystemStats.m_DSPCyclesMax) g_SystemStats.m_DSPCyclesMax = cycles;
        if (cycles < g_SystemStats.m_DSPCyclesMin) g_SystemStats.m_DSPCyclesMin = cycles;
        g_SystemStats.m_DSPCyclesPrev = cycles;
    }
}

///////////////////////////////////////////////////////////////////////////////
///
///////////////////////////////////////////////////////////////////////////////

ISR(DMA_CH1_vect)
{
    if ( DMA.INTFLAGS & DMA_CH1TRNIF_bm )
    {
        uint16_t cycles = SYSTEM_TIMER.CNT;
        DMA.INTFLAGS = DMA_CH1TRNIF_bm;
        HandleDMAInterrupt(1);
        cycles = SYSTEM_TIMER.CNT - cycles;
        if (cycles > g_SystemStats.m_DSPCyclesMax) g_SystemStats.m_DSPCyclesMax = cycles;
        if (cycles < g_SystemStats.m_DSPCyclesMin) g_SystemStats.m_DSPCyclesMin = cycles;
        g_SystemStats.m_DSPCyclesPrev = cycles;
    }
}

    static uint8_t timerUpdateCmd = (0x01<<2); // TC_TC0_CMD_UPDATE_gc;

///////////////////////////////////////////////////////////////////////////////
///
///////////////////////////////////////////////////////////////////////////////

void PWMController::Initialize()
{
    DigitalPort::SetLow(PWM_OUT_PORT, PWM_HIGH_PINS);
    DigitalPort::SetHigh(PWM_OUT_PORT, PWM_LOW_PINS);
    DigitalPort::SetAsOutput(PWM_OUT_PORT, PWM_OUT_PINS);
    PWM_OUT_PORT->PIN0CTRL = PORT_ISC_FALLING_gc;
    PWM_OUT_PORT->PIN3CTRL = PORT_ISC_FALLING_gc;
    
    // Setup timer
    PWM_TIMER.CTRLB = TC0_CCAEN_bm | TC0_CCBEN_bm | TC0_CCCEN_bm /*| TC0_CCDEN_bm*/ | TC_WGMODE_DSBOTH_gc;

    // Setup waveform generator:

    EVSYS.CH2MUX = EVSYS_CHMUX_ACB_WIN_gc;
    EVSYS.CH2CTRL = EVSYS_DIGFILT_1SAMPLE_gc;
	
    AWEXC.CTRL = PWM_AWEX_CHANNELS;
    AWEXC.OUTOVEN = PWM_OUT_PINS;
    AWEXC.DTLSBUF = 4;
    AWEXC.DTHSBUF = 4;
    AWEXC.FDEMASK = PWM_FAULT_EVENTS; // Event 2 = fault
    AWEXC.FDCTRL = AWEX_FDACT_CLEAROE_gc; // | AWEX_FDMODE_bm;
	
    HIRESC.CTRLA = HIRES_HREN0_bm | BIT(2,1);
	
        
    SetPeriod(CPU_FREQ * 4 / 81894);
    SetDutyCycle(0);
    PWM_TIMER.PER = PWM_TIMER.PERBUF;
    PWM_TIMER.CCA = PWM_TIMER.CCABUF;
    PWM_TIMER.CCB = PWM_TIMER.CCBBUF;
    PWM_TIMER.CCC = PWM_TIMER.CCCBUF;
    PWM_TIMER.CCD = PWM_TIMER.CCDBUF;
            
    // Setup pins:
//    PORTD.PIN1CTRL = PORT_ISC_LEVEL_gc | PORT_OPC_PULLUP_gc | PORT_INVEN_bm;
    //    AWEXC.STATUS |= AWEX_FDF_bm;
    PWM_TIMER.CTRLA = TC_CLKSEL_DIV1_gc;
    
    DMA.CTRL = DMA_ENABLE_bm | DMA_DBUFMODE_CH01_gc | DMA_PRIMODE_RR0123_gc;
    SetupModulationDMAChannel(DMA.CH0, g_ModulationDMABuffer[0], &PWM_TIMER.PWM_CMP_LO_PWM);
    SetupModulationDMAChannel(DMA.CH1, g_ModulationDMABuffer[1], &PWM_TIMER.PWM_CMP_LO_PWM);

    DMA.CH0.CTRLB = DMA_CH_TRNINTLVL_MED_gc;
    DMA.CH1.CTRLB = DMA_CH_TRNINTLVL_MED_gc;
    
    PWM_MODULATION_EVCH_MUX = PWM_MODULATION_EVENT_TRIGGER_SRC;
    PWM_MODULATION_EVCH_CTRL = EVSYS_DIGFILT_1SAMPLE_gc;
    
    PWM_MODULATION_TIMER.PERBUF = CPU_FREQ / m_ModulationSampleRate;

    DMA.CH3.TRFCNT    = 1;
    DMA.CH3.REPCNT    = 0;
    DMA.CH3.ADDRCTRL  = DMA_CH_SRCDIR_FIXED_gc | DMA_CH_SRCRELOAD_NONE_gc | DMA_CH_DESTDIR_FIXED_gc | DMA_CH_DESTRELOAD_NONE_gc;
    DMA.CH3.SRCADDR0 = ((intptr_t)&timerUpdateCmd) & 0xff;
    DMA.CH3.SRCADDR1 = (((intptr_t)&timerUpdateCmd) >> 8) & 0xff;
    DMA.CH3.SRCADDR2  = 0;
    DMA.CH3.DESTADDR0  = ((intptr_t)&PWM_TIMER.CTRLFSET) & 0xff;
    DMA.CH3.DESTADDR1  = (((intptr_t)&PWM_TIMER.CTRLFSET) >> 8) & 0xff;
    DMA.CH3.DESTADDR2 = 0;
    DMA.CH3.TRIGSRC   = DMA_CH_TRIGSRC_TCC0_CCC_gc;
    DMA.CH3.CTRLA     = DMA_CH_ENABLE_bm | DMA_CH_REPEAT_bm | DMA_CH_SINGLE_bm | DMA_CH_BURSTLEN_1BYTE_gc;

/*    for ( int16_t i = 0 ; i < 512 ; ++i ) {
        m_ModulationBufferLS[0][i] = i>>1;
        m_ModulationBufferHS[0][i] = 800 - m_ModulationBufferHS[0][i];
        m_ModulationBufferLS[1][i] = (512-i)>>1;
        m_ModulationBufferHS[1][i] = 800 - m_ModulationBufferHS[0][i];
    }*/
}

///////////////////////////////////////////////////////////////////////////////
///
///////////////////////////////////////////////////////////////////////////////

void PWMController::Run()
{
    static int32_t prevUpdateTime = 0;
    static bool state = false;
    uint32_t time = Clock::GetTime();
    
    if ((time - prevUpdateTime) > 10)
    {
        if (state)
        {
            SetDutyCycle(0);
            state = false;
        }
        else
        {
            SetDutyCycle(65535);
            state = true;
        }
    }
}

///////////////////////////////////////////////////////////////////////////////
///
///////////////////////////////////////////////////////////////////////////////

void PWMController::SetupModulationDMAChannel(DMA_CH_t& channel, volatile PWMModulationPair* srcAddr, volatile uint16_t* pwmRegister)
{
    channel.CTRLA = DMA_CH_REPEAT_bm | DMA_CH_SINGLE_bm | DMA_CH_BURSTLEN_4BYTE_gc;
    channel.TRFCNT = 4; // MODULATION_BUFFER_SIZE * 2;
    channel.ADDRCTRL = DMA_CH_SRCDIR_INC_gc | DMA_CH_SRCRELOAD_TRANSACTION_gc | DMA_CH_DESTDIR_INC_gc | DMA_CH_DESTRELOAD_BURST_gc;
    channel.SRCADDR0 = ((intptr_t)srcAddr) & 0xff;
    channel.SRCADDR1 = (((intptr_t)srcAddr) >> 8) & 0xff;
    //	channel.SRCADDR2 = (((intptr_t)pwmVariable) >> 16) & 0xff;
    channel.DESTADDR0 = ((intptr_t)pwmRegister) & 0xff;
    channel.DESTADDR1 = (((intptr_t)pwmRegister) >> 8) & 0xff;
    //	channel.DESTADDR2 = (((intptr_t)pwmRegister) >> 16) & 0xff;
    channel.TRIGSRC = PWM_MODULATION_DMA_TRIGGER;
}

///////////////////////////////////////////////////////////////////////////////
/// Set the PWM counter top value.
///////////////////////////////////////////////////////////////////////////////

void PWMController::SetPeriod(uint16_t period)
{
    g_PWMThreshold = (U32(g_DutyCycle) * period + 65536) >> 17; // / (65535*2);
    g_PWMModulationCenter = g_PWMThreshold - ((127 * g_ModulationMultiplier) >> g_ModulationShifter);    
//    g_PWMMinThreshold = 64; //period / 10; // Never allow duty cycle between 0% and 5% as it confuses the H-bridge.
//    g_PWMMaxSampleDelta = period / 2;
    PWM_TIMER.PERBUF    = period;
    PWM_TIMER.PWM_CMP_MID = period >> 1;    // We use CCC to detect underflow and CCD to detect overflow for current measurements.
    
    if (!IsModulating() && !IsFaulty()) {
        PWM_TIMER.PWM_CMP_LO_PWM = g_PWMThreshold;
        PWM_TIMER.PWM_CMP_HI_PWM = PWM_TIMER.PER - g_PWMThreshold;
    }        
}

///////////////////////////////////////////////////////////////////////////////
///
///////////////////////////////////////////////////////////////////////////////

uint16_t PWMController::GetPeriod() const
{
    return PWM_TIMER.PERBUF;
}

///////////////////////////////////////////////////////////////////////////////
/// Set PWM duty cycle. Input between 0x0000 (0%) and 0xffff (100%)
///////////////////////////////////////////////////////////////////////////////
    
void PWMController::SetDutyCycle(uint16_t dutyCycle)
{
    g_DutyCycle = dutyCycle;
    
//    uint16_t pwm = U32(dutyCycle) * PWM_TIMER.PERBUF / (65535*2);
    g_PWMThreshold = (U32(dutyCycle) * PWM_TIMER.PERBUF + 65536) >> 17; // / (65535*2);
//    if (g_PWMThreshold != 0 && g_PWMThreshold < g_PWMMinThreshold) {
//        g_PWMThreshold = g_PWMMinThreshold;
//    }
    g_PWMModulationCenter = g_PWMThreshold - ((127 * g_ModulationMultiplier) >> g_ModulationShifter);
    
    cli();
    if (!IsModulating() && !IsFaulty()) {
        PWM_TIMER.PWM_CMP_LO_PWM = g_PWMThreshold;
        PWM_TIMER.PWM_CMP_HI_PWM = PWM_TIMER.PERBUF - g_PWMThreshold;
    }
    sei();
}

///////////////////////////////////////////////////////////////////////////////
///
///////////////////////////////////////////////////////////////////////////////

uint16_t PWMController::GetDutyCycle() const
{
    return g_DutyCycle;
}

///////////////////////////////////////////////////////////////////////////////
/// Sets any flags mentioned in 'faults' plus the e_FaultActive flag.
///////////////////////////////////////////////////////////////////////////////

void PWMController::SetFaultFlags(uint8_t faults)
{
    bool wasFaulty = IsFaulty();
    m_FaultFlags |= faults; // | e_FaultActive;
    if (wasFaulty != IsFaulty())
    {
        PWM_TIMER.PWM_CMP_LO_PWM = 0;
        PWM_TIMER.PWM_CMP_HI_PWM = 0;
    }
}

///////////////////////////////////////////////////////////////////////////////
///
///////////////////////////////////////////////////////////////////////////////

void PWMController::ClearFaultFlags(uint8_t faults)
{
    bool wasFaulty = IsFaulty();
    m_FaultFlags &= U8(~faults);
    if (wasFaulty != IsFaulty())
    {
        PWM_TIMER.PWM_CMP_LO_PWM = g_PWMThreshold;
        PWM_TIMER.PWM_CMP_HI_PWM = PWM_TIMER.PERBUF - g_PWMThreshold;
    }
}

///////////////////////////////////////////////////////////////////////////////
///
///////////////////////////////////////////////////////////////////////////////

void PWMController::SetDeadTime(uint8_t deadTimeLS, uint8_t deadTimeHS)
{
    AWEXC.DTLSBUF = deadTimeLS;
    AWEXC.DTHSBUF = deadTimeHS;
}

///////////////////////////////////////////////////////////////////////////////
///
///////////////////////////////////////////////////////////////////////////////

void PWMController::GetDeadTime(uint8_t* deadTimeLS, uint8_t* deadTimeHS) const
{
    *deadTimeLS = AWEXC.DTLSBUF;
    *deadTimeHS = AWEXC.DTHSBUF;
}

///////////////////////////////////////////////////////////////////////////////
///
///////////////////////////////////////////////////////////////////////////////

int16_t PWMController::GetAvaialbleModulationDataSpace() const
{
    cli();
    int16_t sizeAvail = g_ModulationBufferBytesAvailable;
    sei();
    return PWM_MODULATION_BUFFER_SIZE - sizeAvail;
}

///////////////////////////////////////////////////////////////////////////////
///
///////////////////////////////////////////////////////////////////////////////

int16_t PWMController::WriteModulationData(const uint8_t* data, int16_t size)
{
    cli();
    int16_t availableSize = g_ModulationBufferBytesAvailable;
    sei();
    availableSize = PWM_MODULATION_BUFFER_SIZE - availableSize;
    if (size > availableSize) {
        printf_P(PSTR("ERROR: Modulation buffer overflow! %d > %d\n"), size, availableSize);
        size = availableSize;
    }
    //printf_P(PSTR("WriteModulationData: %d/%d\n"), size, origSize);
    for(int16_t i = 0 ; i < size ; ++i)
    {
        g_ModulationBuffer[g_ModulationBufferInPos++] = *(data++);
        g_ModulationBufferInPos &= PWM_MODULATION_BUFFER_SIZE - 1;
    }
    cli();
    g_ModulationBufferBytesAvailable += size;
    bool restart = g_ModulationBufferBytesAvailable && !IsModulating();
    sei();
    if (restart)
    {
//        g_LastModulationBufferSample = g_PWMThreshold;
        FillDMABuffers(0);
        FillDMABuffers(1);
        DMA.CH0.CTRLA = DMA_CH_ENABLE_bm | DMA_CHANNEL_CTRL;
        PWM_MODULATION_TIMER.CTRLA = TC_CLKSEL_DIV1_gc;
    }
    return size;
}

///////////////////////////////////////////////////////////////////////////////
///
///////////////////////////////////////////////////////////////////////////////
    
void PWMController::SetModulationSampleRate(uint16_t sampleRate)
{
    m_ModulationSampleRate = sampleRate;    
    PWM_MODULATION_TIMER.PERBUF = CPU_FREQ / m_ModulationSampleRate;
}

///////////////////////////////////////////////////////////////////////////////
///
///////////////////////////////////////////////////////////////////////////////

uint16_t PWMController::GetModulationSampleRate() const
{
    return m_ModulationSampleRate;
}

///////////////////////////////////////////////////////////////////////////////
///
///////////////////////////////////////////////////////////////////////////////

void PWMController::SetModulationScale(uint8_t multiplier, uint8_t rightShifter)
{
    uint16_t center = g_PWMThreshold - ((127 * multiplier) >> rightShifter);
    cli();
    g_ModulationMultiplier = multiplier;
    g_ModulationShifter = rightShifter;
    g_PWMModulationCenter = center;
    sei();
}

///////////////////////////////////////////////////////////////////////////////
///
///////////////////////////////////////////////////////////////////////////////

void PWMController::GetModulationScale( uint8_t& multiplier, uint8_t& rightShifter ) const
{
    multiplier   = g_ModulationMultiplier;
    rightShifter = g_ModulationShifter;    
}

///////////////////////////////////////////////////////////////////////////////
///
///////////////////////////////////////////////////////////////////////////////

bool PWMController::IsModulating()
{
    return PWM_MODULATION_TIMER.CTRLA != 0;
}
