kavionic/TeslaDriver/Software/TeslaTuner/TeslaTuner/TeslaTuner.h

// This file is part of TeslaTuner.
//
// Copyright (C) 2016 Kurt Skauen <http://kavionic.com/>
//
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

#ifndef TESLATUNER_H
#define TESLATUNER_H

#include <QtWidgets/QMainWindow>
#include <QtNetwork/QTcpSocket.h>

#include "AudioPlayer.h"

#include "ui_TeslaTuner.h"


struct DeviceInfo
{
    WifiBootMode_e m_CurrentBootMode   = WifiBootMode_e::e_Application;
    WifiBootMode_e m_PreferredBootMode   = WifiBootMode_e::e_Application;
    int32_t        m_NetworkBufferSize = 0;
    uint32_t       m_FlashPageSize     = 0;
    uint32_t       m_FlashStartAddress = 0;
    uint32_t       m_FlashSize         = 0;
};

class TeslaTuner : public QMainWindow, public Ui::TeslaTunerClass
{
    Q_OBJECT

public:
    TeslaTuner(QWidget *parent = 0);
    ~TeslaTuner();

    virtual void closeEvent(QCloseEvent* event) override;

    static const DeviceInfo& GetDeviceInfo() { return s_DeviceInfo; }
private slots:
    void SlotConnectionStateChanged(QAbstractSocket::SocketState state);
    void SlotAudioPlayerStateChanged(AudioPlayer::State_e state);
    void SlotAudioDurationChanged(double duration);
    void SlotAudioPositionChanged(double position);
    void SlotAudioPositionSliderChanged(int value);

    void SlotSocketDataReady();
    void SlotRefreshTimer();
    
    void SlotFrequencySliderChanged(int value);
    void UpdateFrequencySliderValue();

    void SlotDutyCycleSliderChanged(int value);
    void UpdateDutyCycleSliderValue();
   
    void SlotDeadTimeLSSliderChanged(int value);
    void SlotDeadTimeHSSliderChanged(int value);

    void UpdateDeadTimeLSSliderValue();
    void UpdateDeadTimeHSSliderValue();

    void SlotCurrentLimitLowSliderChanged(int value);
    void SlotCurrentLimitHighSliderChanged(int value);

    void UpdateCurrentLimitLowSliderValue();
    void UpdateCurrentLimitHighSliderValue();

    void SlotTemperatureResolutionSliderChanged(int value);
    void UpdateTemperatureResolutionValue();


    void SlotVolumeSliderChanged(int value);
    void UpdateVolumeSliderValue();

    void SlotSampleRateSliderChanged(int value);
    void UpdateSampleRateSliderValue();

    void SlotAudioPathSelected(int index);
    void SlotBrowseAudioFile();
    void SlotPlayButton();
    void SlotStopButton();

private:
    void ReconnectDevice();
    void SendPing();
    void RequestRadioStatus();
    void RequestPWMStatus();
    void ReadVoltageRails();
    void SendModulationData();

    void EnableControls(bool enable);
    void UpdatePWMStatusView();
    void UpdateSystemStatusView();
    void ProcessResponse();

    static DeviceInfo s_DeviceInfo;

    QTcpSocket m_DeviceSocket;
    QTimer     m_RefreshTimer;
    QElapsedTimer m_TimeSinceSystemInfoRequest;
    QElapsedTimer m_TimeSincePWMStatusRequest;
    QElapsedTimer m_TimeSinceReadVoltageRailsRequest;
    QElapsedTimer m_TimeSinceModulationSent;
    uint64_t      m_ModulationSendTime = 0;
    double        m_ModulationBitrate = 0.0;
    bool                  m_IsStatusUpdatePending = false;
    bool                  m_IsPWMStatusValid = false;

    bool                  m_IsReadVoltageRailsPending = false;
    bool                  m_IsVoltageRailsStatusValid = false;
    bool                  m_UpdateSliders = false; // Set to true when connection established and to false on the first update from the device.

    WifiGetPWMStatusReply     m_PWMStatus;
    WifiReadVoltageRailsReply m_VoltageRailsStatus;

    bool m_IsModulationDataPending = false;

    union
    {
        char                      m_Buffer[1];
        WifiPackageHeader         m_Header;
        WifiSetVal16              m_SetVal16;
        WifiSetVal32              m_SetVal32;
        WifiGetSystemInfoReply    m_GetSystemInfoReply;
        WifiGetRadioStatusReply   m_GetRadioStatusReply;
        WifiGetPWMStatusReply     m_GetPWMStatusReply;
        WifiReadVoltageRailsReply m_ReadVoltageRailsReply;
    } m_ResponsePackages;
    int m_ResponseBytesReceived = 0;

    AudioPlayer m_AudioPlayer;
    QString     m_AudioFilePath;
};

#endif // TESLATUNER_H
