kavionic/TeslaDriver/Firmware/TeslaDriver/TeslaDriver/Beeper.cpp

// This file is part of TeslaDriver.
//
// Copyright (C) 2016 Kurt Skauen <http://kavionic.com/>
//
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

#include <avr/pgmspace.h>
#include <util/atomic.h>

#include "Beeper.h"

uint8_t Beeper::s_TimerSkipCount;
uint8_t Beeper::g_BeepEndTime;
uint8_t Beeper::g_AlarmCycleCount;
uint8_t Beeper::g_AlarmCycle;
uint8_t Beeper::s_BuzzerFrequency;
uint8_t Beeper::s_MuteFlags;

///////////////////////////////////////////////////////////////////////////////
///
///////////////////////////////////////////////////////////////////////////////

void Beeper::Initialize()
{
    DigitalPort::InvertPins(BUZZER_PORT,BUZZER_PIN2);
    DigitalPort::SetHigh(BUZZER_PORT,BUZZER_PIN2);
    DigitalPort::SetAsOutput(BUZZER_PORT, BUZZER_PIN1 | BUZZER_PIN2);

    SetBuzzerFrequency(Config::GetBuzzerFrequency());
    SetBuzzerVolume(Config::GetBuzzerVolume());
}

///////////////////////////////////////////////////////////////////////////////
///
///////////////////////////////////////////////////////////////////////////////

void Beeper::Mute(SoundCategory::Enum category, bool mute)
{
    if ( mute ) {
        s_MuteFlags |= BIT8(category, 1);
    } else {
        s_MuteFlags &= U8(~BIT8(category, 1));
    }
}

///////////////////////////////////////////////////////////////////////////////
///
///////////////////////////////////////////////////////////////////////////////

bool Beeper::IsMuted(SoundCategory::Enum category)
{
    return (s_MuteFlags & BIT8(category, 1)) != 0;
}

///////////////////////////////////////////////////////////////////////////////
///
///////////////////////////////////////////////////////////////////////////////

void Beeper::SetMuteFlags(uint8_t flags)
{
    s_MuteFlags = flags;
}

///////////////////////////////////////////////////////////////////////////////
///
///////////////////////////////////////////////////////////////////////////////

uint8_t Beeper::GetMuteFlags()
{
    return s_MuteFlags;
}

///////////////////////////////////////////////////////////////////////////////
///
///////////////////////////////////////////////////////////////////////////////

void Beeper::Beep(BeepID::Enum beepID)
{
    if ( beepID == BeepID::e_Cancel )
    {
        if ( IsMuted(SoundCategory::e_Alarm) ) {
            return;
        }
    }
    else if ( beepID == BeepID::e_StartCountDown || beepID == BeepID::e_FinishCountDown || beepID == BeepID::e_StartRadiating )
    {
        if ( IsMuted(SoundCategory::e_Progress) ) {
            return;
        }
    }
    else if ( IsMuted(SoundCategory::e_Tactile) )
    {
        return;
    }
    BeepTimed(Config::GetBeepLength(beepID));
}

///////////////////////////////////////////////////////////////////////////////
///
///////////////////////////////////////////////////////////////////////////////

void Beeper::BeepTimed(uint8_t duration)
{
    Enable(true);
    
    ATOMIC_BLOCK(ATOMIC_RESTORESTATE)
    {
        s_TimerSkipCount = TIME_PER_TICK;
        g_AlarmCycleCount = 0;
        g_BeepEndTime = duration;
    }        
}

///////////////////////////////////////////////////////////////////////////////
///
///////////////////////////////////////////////////////////////////////////////

void Beeper::Alarm()
{
    ATOMIC_BLOCK(ATOMIC_RESTORESTATE)
    {
        s_TimerSkipCount = TIME_PER_TICK;
        g_BeepEndTime = 1;
        g_AlarmCycle = 0;
        g_AlarmCycleCount = Config::GetAlarmCycleCount() << 1;
    }        
}

///////////////////////////////////////////////////////////////////////////////
///
///////////////////////////////////////////////////////////////////////////////

void Beeper::SetBuzzerVolume( uint8_t volume )
{
    BUZZER_TIMER.CCABUF = I32(BUZZER_TIMER.PERBUF) * volume / 200;
    BUZZER_TIMER.CCBBUF = BUZZER_TIMER.PERBUF - BUZZER_TIMER.CCABUF;
}

///////////////////////////////////////////////////////////////////////////////
///
///////////////////////////////////////////////////////////////////////////////

uint8_t Beeper::GetBuzzerVolume()
{
    return U32(BUZZER_TIMER.CCABUF) * 200 / BUZZER_TIMER.PERBUF;
}

///////////////////////////////////////////////////////////////////////////////
///
///////////////////////////////////////////////////////////////////////////////

void Beeper::SetBuzzerFrequency(uint16_t frequency )
{
    BUZZER_TIMER.PERBUF = CPU_FREQ / (frequency * 2);
}

///////////////////////////////////////////////////////////////////////////////
///
///////////////////////////////////////////////////////////////////////////////

uint16_t Beeper::GetBuzzerFrequency()
{
    return CPU_FREQ / 2 / BUZZER_TIMER.PERBUF;
}
