kavionic/TeslaDriver/(commit log)

2016-06-21 Initial commit of firmware, support software, and CAD files for my tesla coil project.
    [TeslaController-B.Cu.gbr, TeslaController-B.Mask.gbr, TeslaController-B.SilkS.gbr, TeslaController-Edge.Cuts.gbr, TeslaController-F.Cu.gbr, TeslaController-F.Mask.gbr, TeslaController-F.SilkS.gbr, TeslaController.drl]
2016-06-23 Decided to send the controller PCB off to China rather than etching myself. So fixed up the silkscreen and reduced via sizes a bit.
    [TeslaController-B.Mask.gbr, TeslaController-B.SilkS.gbr, TeslaController-F.Cu.gbr, TeslaController-F.SilkS.gbr, TeslaController.drl, TeslaController.gbl, TeslaController.gbo, TeslaController.gbp]
2016-06-28 * Redesigned the inverter gate driver. - It will now drive the gate to ~+-12V rather than ~-0.6 to 11.4. - Redesigned the gate clamping to better enforce the gate voltage limit and to more quickly ad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
    * Redesigned the inverter PCB.
    - Made an entirely new layout for the inverter PCB which hopefully
    will be able to carry substantial currents without needing extra
    bus bars. It should also give parasitic inductances on the board
    less oportunity to mess with the GS voltage.
    - Designed for manufacturing on a board-hose rather than home
    etch.
    [TeslaDriver.gbl, TeslaDriver.gbo, TeslaDriver.gbp, TeslaDriver.gbs, TeslaDriver.gtl, TeslaDriver.gto, TeslaDriver.gtp, TeslaDriver.gts]
2016-08-19 Did some small component value tweeks and sorted the BOM.
    [BOM.ods, TeslaDriver.kicad_pcb, TeslaDriver.sch]
2016-08-19 - Some tweaks to the fan controller. - Added a lower-duty-cycle cap to keep it within the capabilities of the inverter. - Added slew-rate limiting to the PWM modulation. - Added support for fault con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
    [TeslaController.ods]
2016-12-16 - Implemented a boot-loader with ESP8266 support allowing the firmware to be updated over WIFI. - Added support for firmware updates in the TeslaTuner application. - Implemented current measurement a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
    [BOM.ods, DualGateDriver.kicad_pcb, DualGateDriver.ods, DualGateDriver.sch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]
2016-12-18 - The main projects now reference a local copy of the shared AVR framework. Makes it possible to change the framework APIs in one project without breaking the others (until they are being manually sy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
2016-12-18 - Changed the value of R30 & R31 to up the current sense reference voltage from 0.5V to 1.65V. - TeslaTuner now show current limits in Amps rather than a number between 0 and 4095.
    [TeslaController.kicad_pcb, TeslaController.sch]
2016-12-21 - Split ADC, DAC, and AC code out of PWMController and into a new class. - Configured ADCA to continousely sample all voltage rails in free-run mode. - At startup, the reference voltage for the curre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
2017-01-07 - Added support for reading the different voltage rail measurements over the WIFI protocol. - Added filtering of the current measurements. - Added support for reusing the ESP8266 setup after a softwa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
    [ADCController.cpp, ADCController.h, BootNetIF.cpp, BootNetIF.h, NetIF.cpp, NetIF.h, PWMController.cpp, TeslaDriver.cpp]
2017-01-07 - Added support for displaying the inverter power rail voltages. - Some tweaks to the UI layout.
2017-03-05 Revision 4 of TeslaDriver & revision 1 of QuadGateDriver.
    [QuadGateDriver.kicad_pcb, QuadGateDriver.sch, TeslaDriver.kicad_pcb, TeslaDriver.ods, TeslaDriver.sch]
2017-03-05 Archive copy of QuadGateDriver Rev 1.
    [QuadGateDriver.kicad_pcb, QuadGateDriver.sch]
